AerospaceNU/bms-pcb-design/bms-kicad-project/bms-layout-pdf/bms-board-B_Cu.pdf

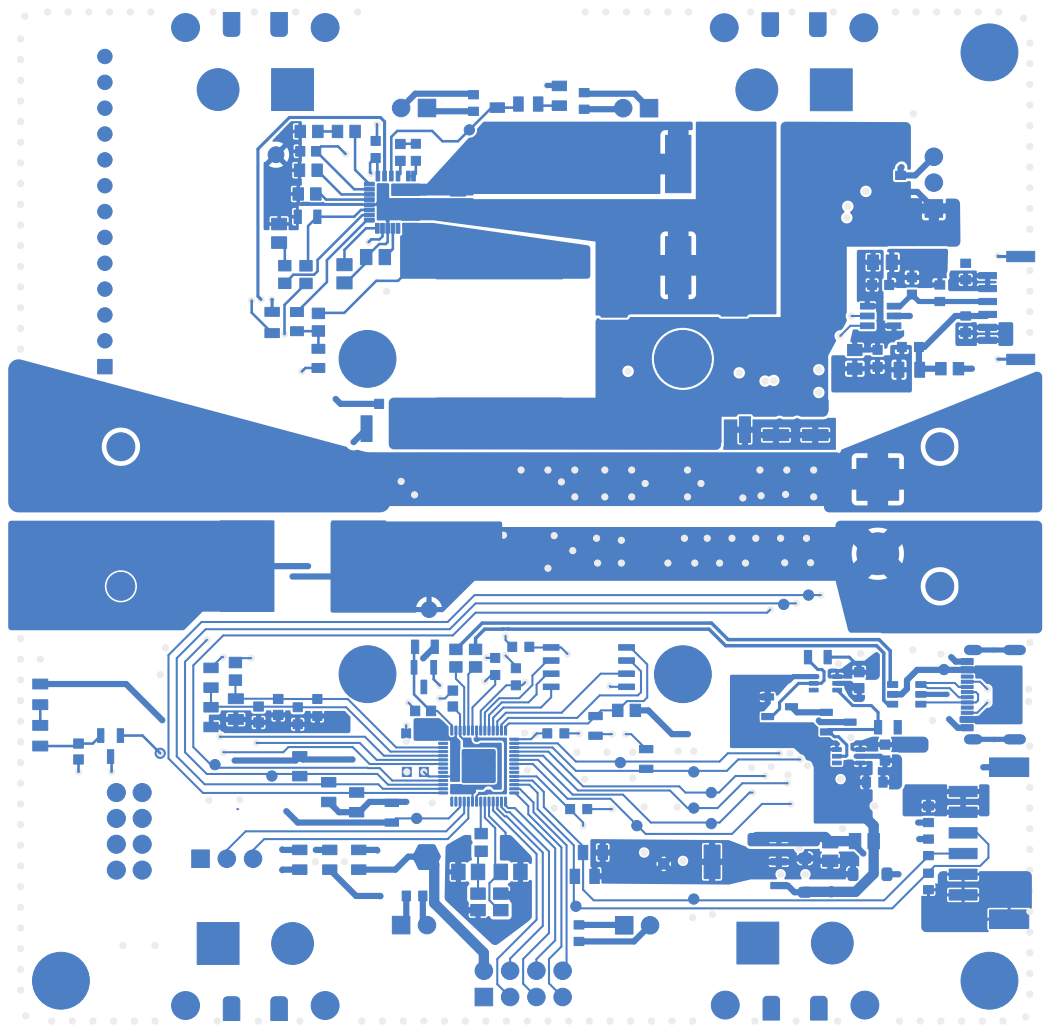
[picture p1: page 1]
