AerospaceNU/bms-pcb-design/bms-kicad-project/bms-layout-pdf/bms-board-B_Mask.pdf

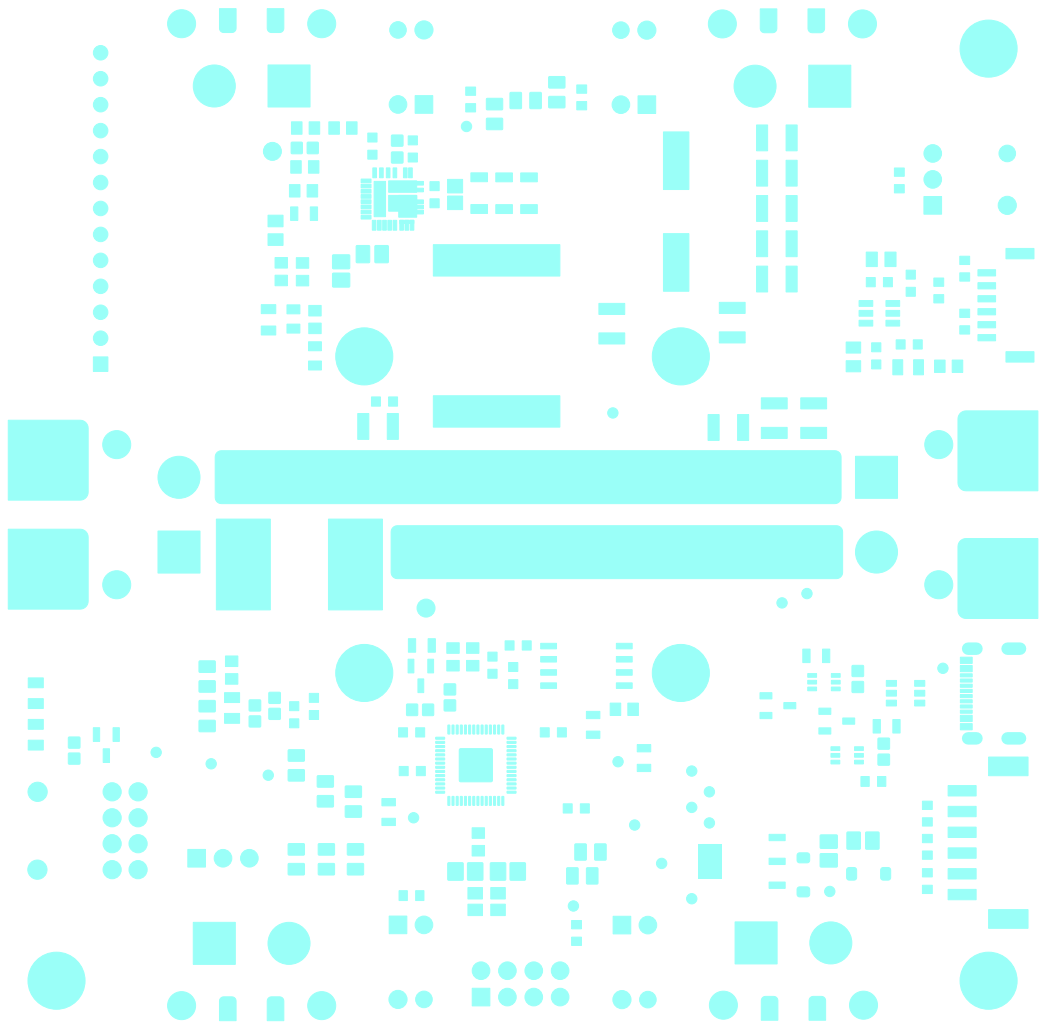
[picture p2: page 1]
