AerospaceNU/bms-pcb-design/bms-kicad-project/bms-layout-pdf/bms-board-B_Paste.pdf

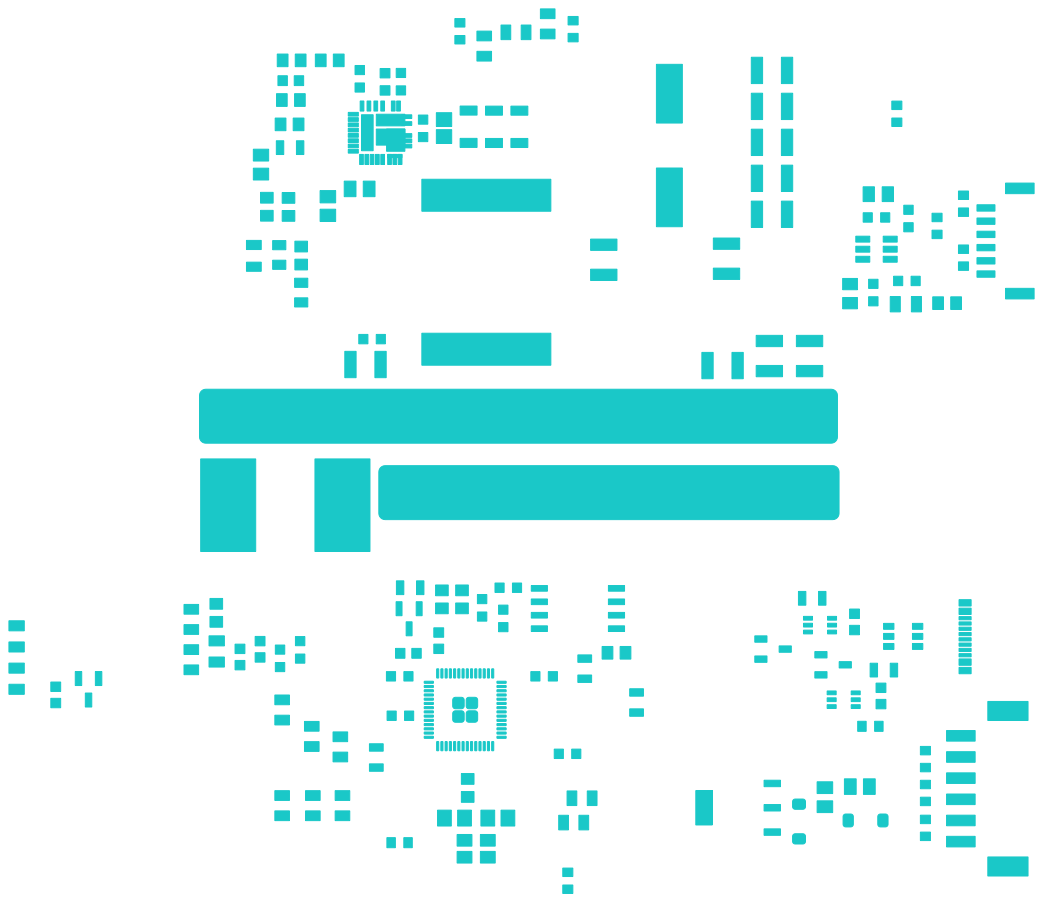
[picture p3: page 1]
