AerospaceNU/bms-pcb-design/bms-kicad-project/bms-layout-pdf/bms-board-B_Silkscreen.pdf

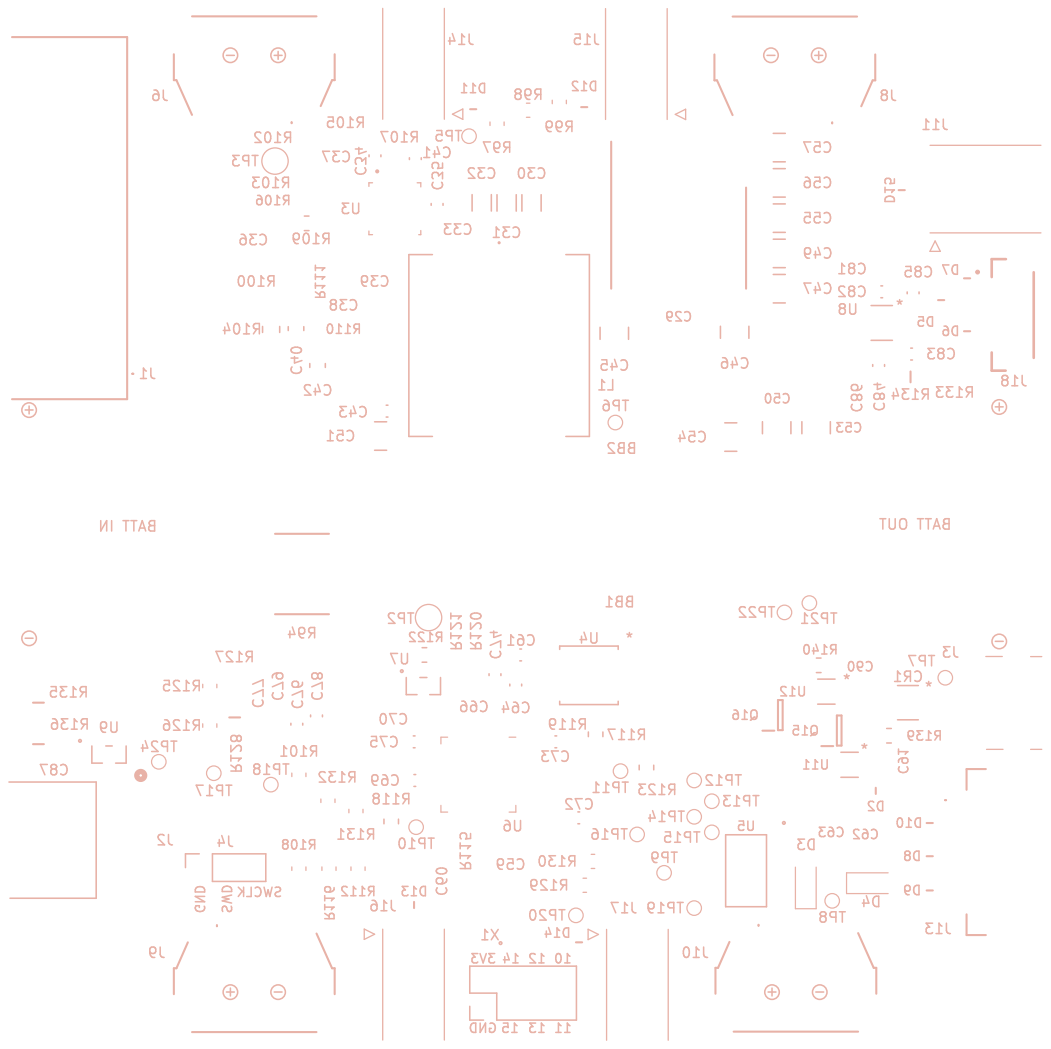
[picture p4: page 1]
