AerospaceNU/bms-pcb-design/bms-kicad-project/bms-layout-pdf/bms-board-Edge_Cuts.pdf

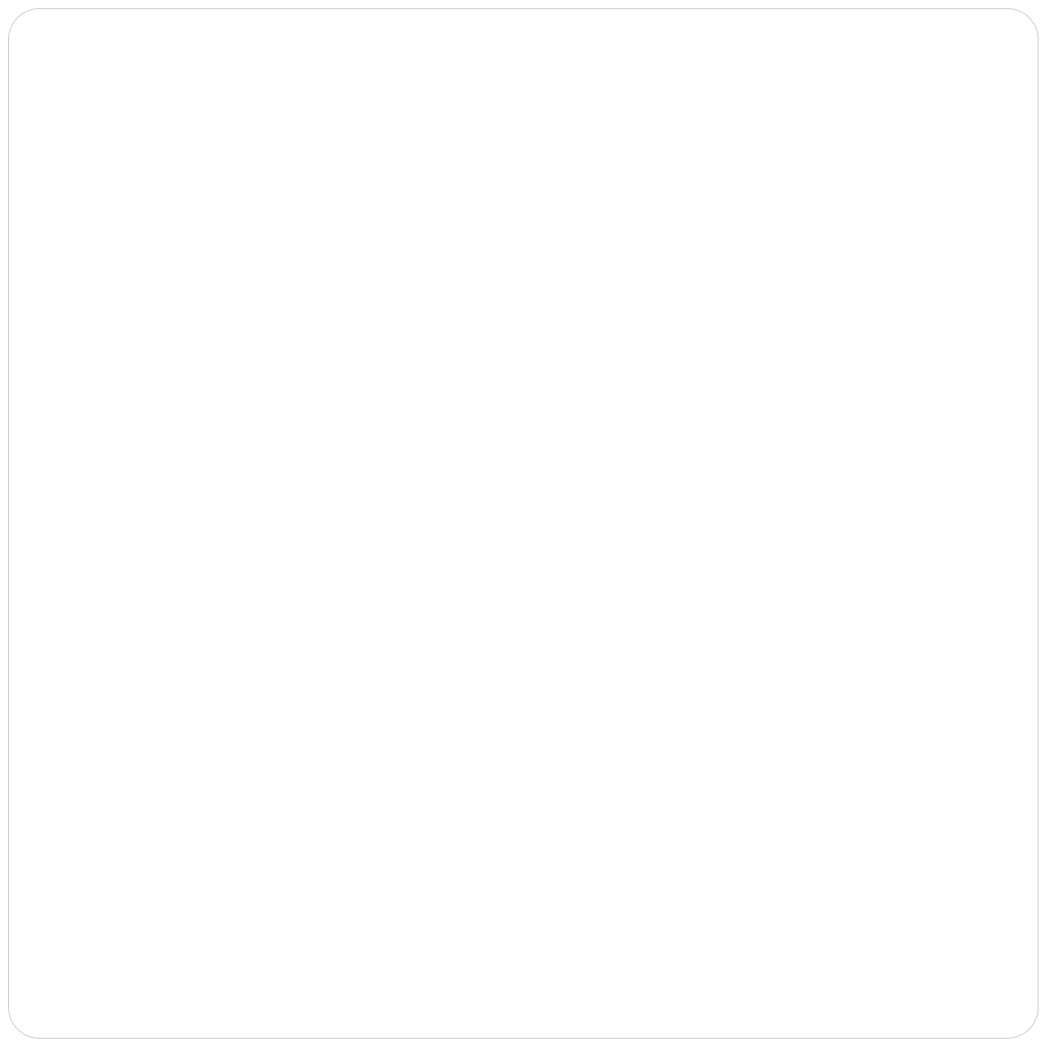
[picture p5: page 1]
