AerospaceNU/bms-pcb-design/bms-kicad-project/bms-layout-pdf/bms-board-F_Cu.pdf

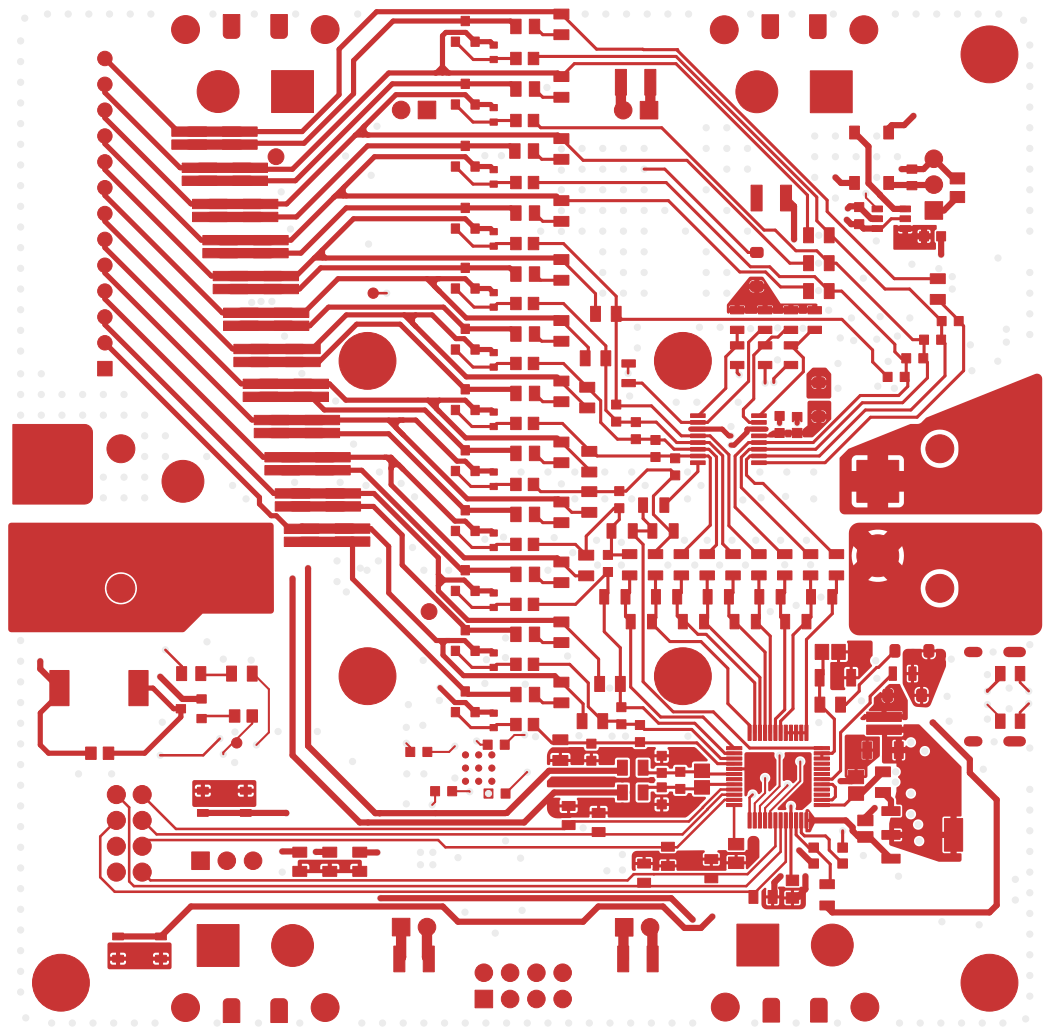
[picture p6: page 1]
