AerospaceNU/bms-pcb-design/bms-kicad-project/bms-layout-pdf/bms-board-F_Mask.pdf

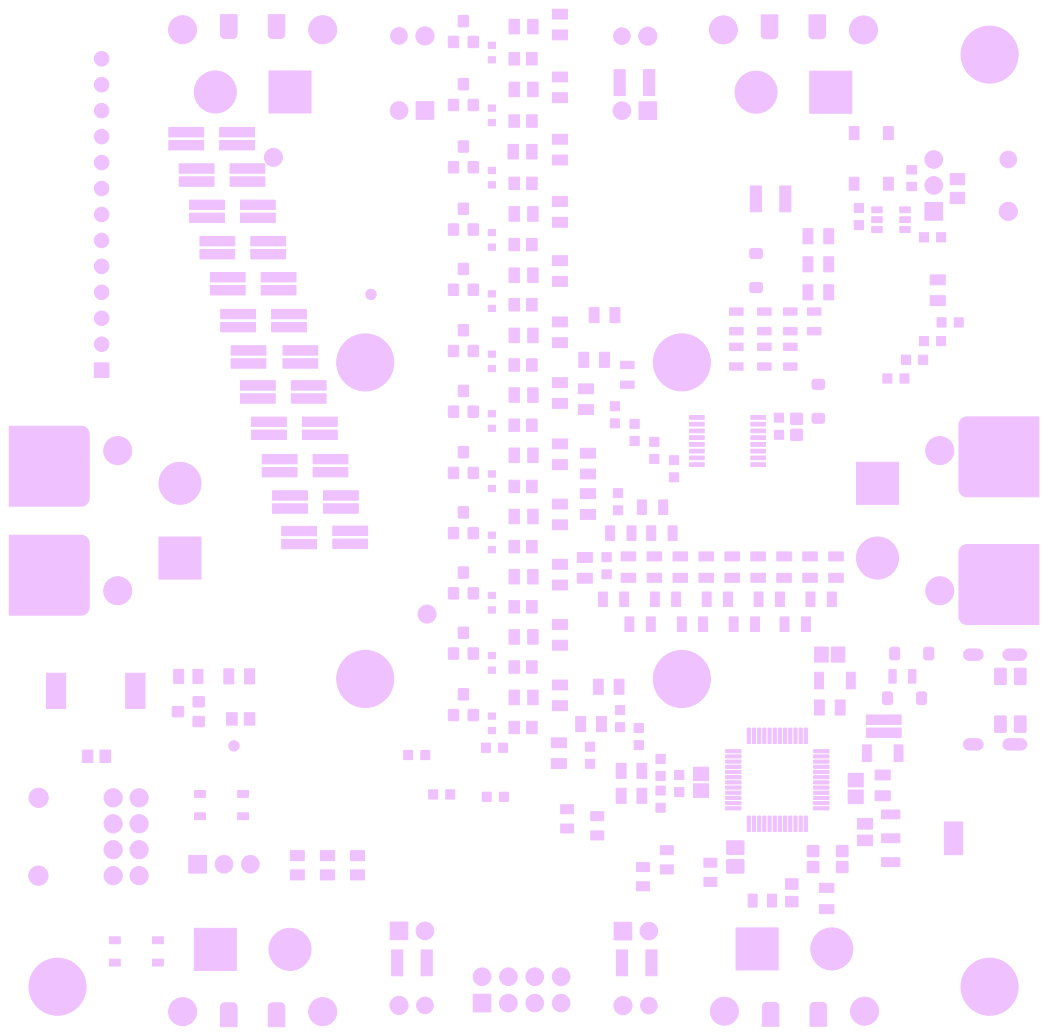
[picture p7: page 1]
