AerospaceNU/bms-pcb-design/bms-kicad-project/bms-layout-pdf/bms-board-F_Paste.pdf

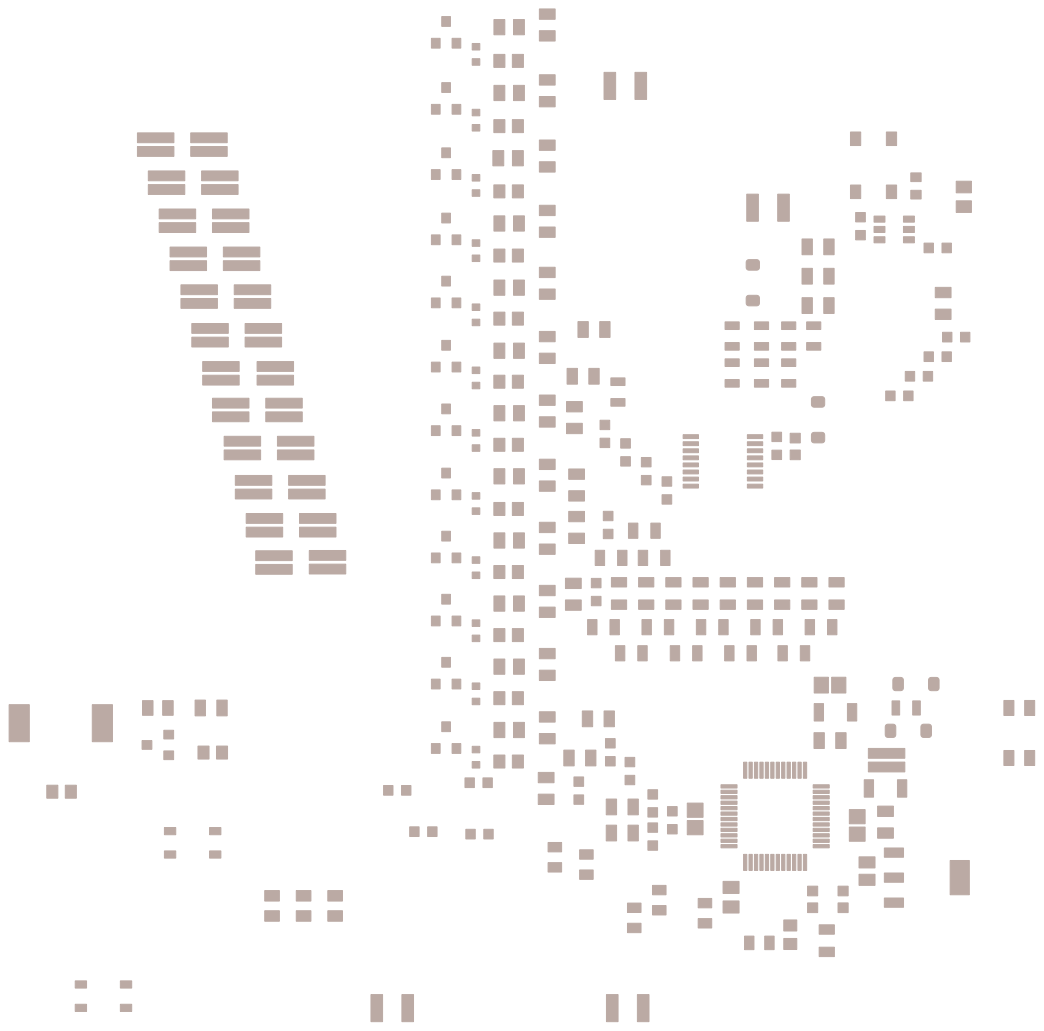
[picture p8: page 1]
