AerospaceNU/bms-pcb-design/bms-kicad-project/bms-layout-pdf/bms-board-F_Silkscreen.pdf

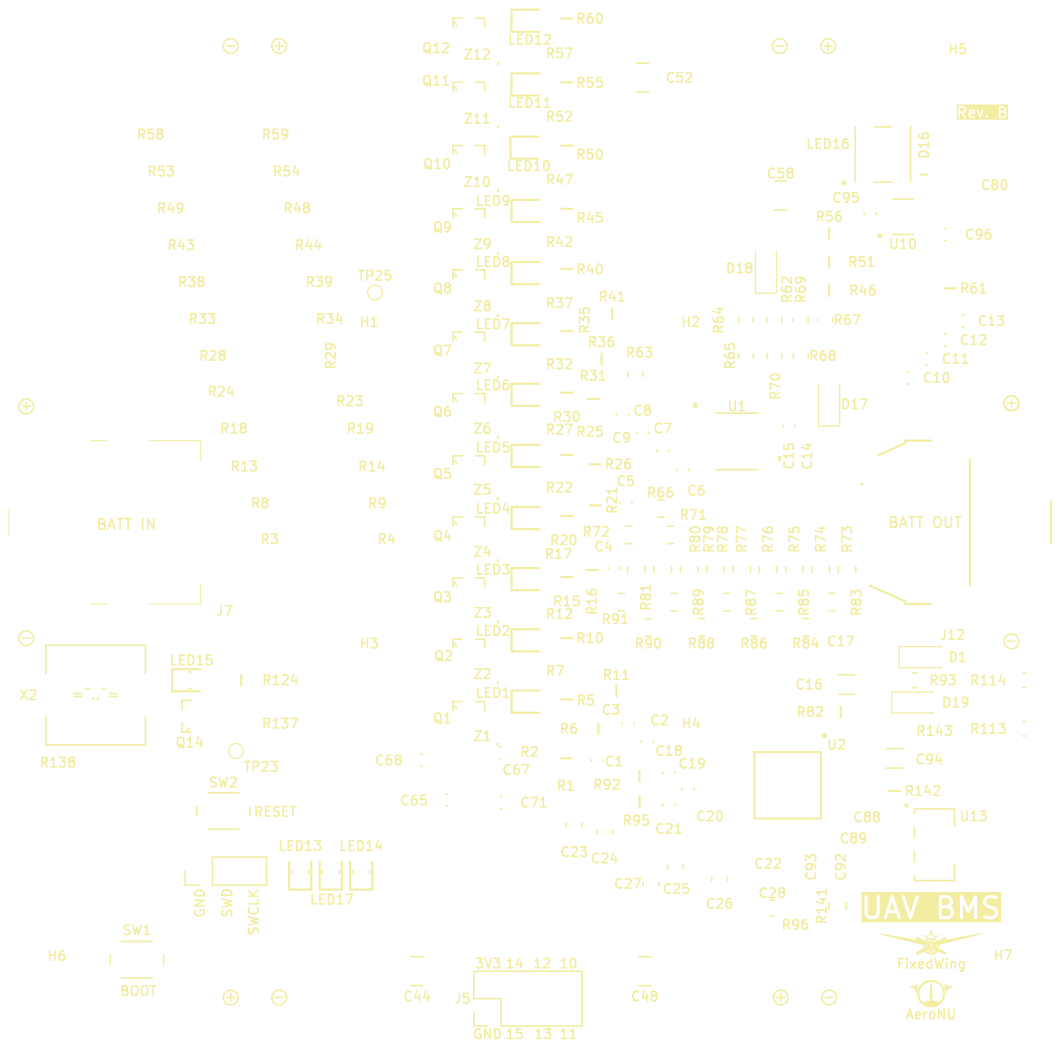
[picture p9: page 1]
