AerospaceNU/bms-pcb-design/bms-kicad-project/bms-layout-pdf/bms-board-In1_Cu.pdf

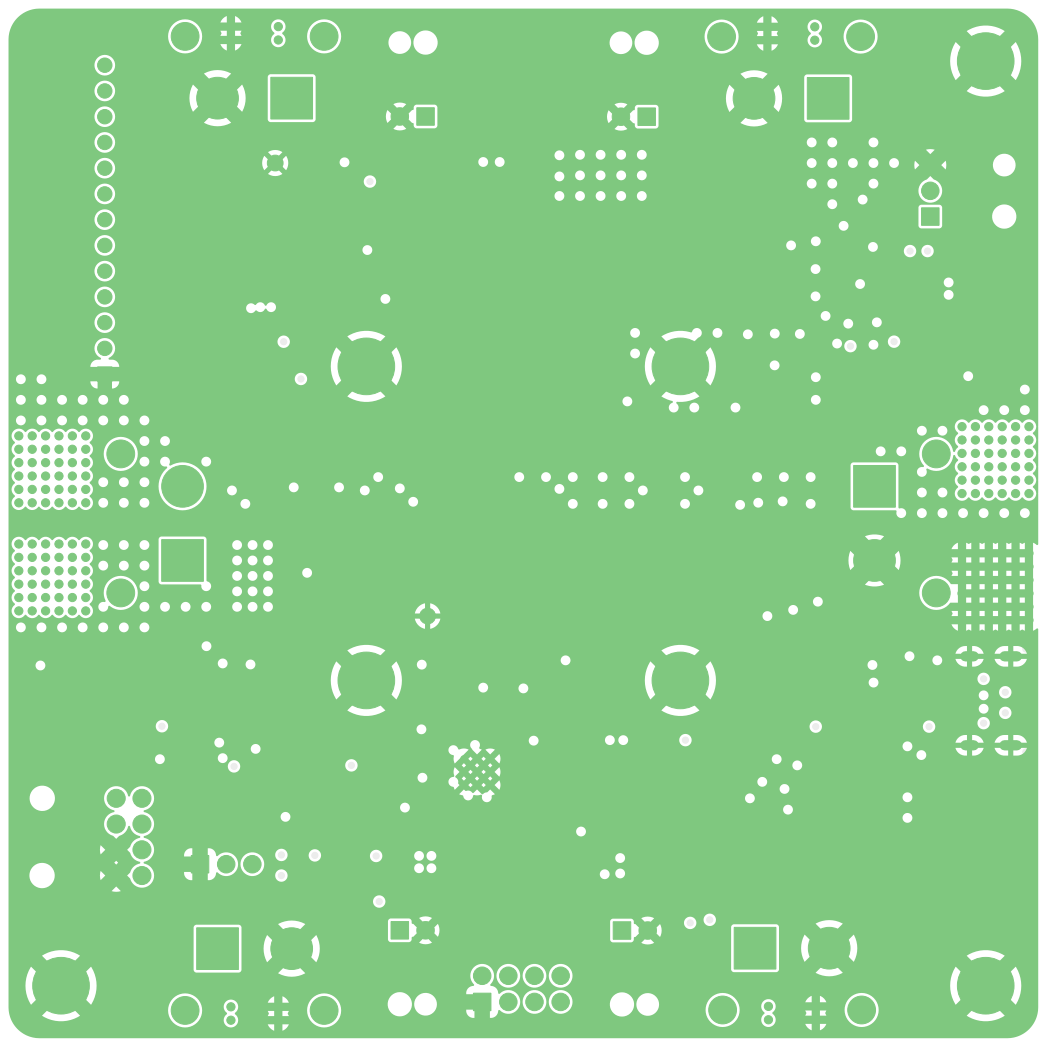
[picture p10: page 1]
