AerospaceNU/bms-pcb-design/bms-kicad-project/bms-layout-pdf/bms-board-In2_Cu.pdf

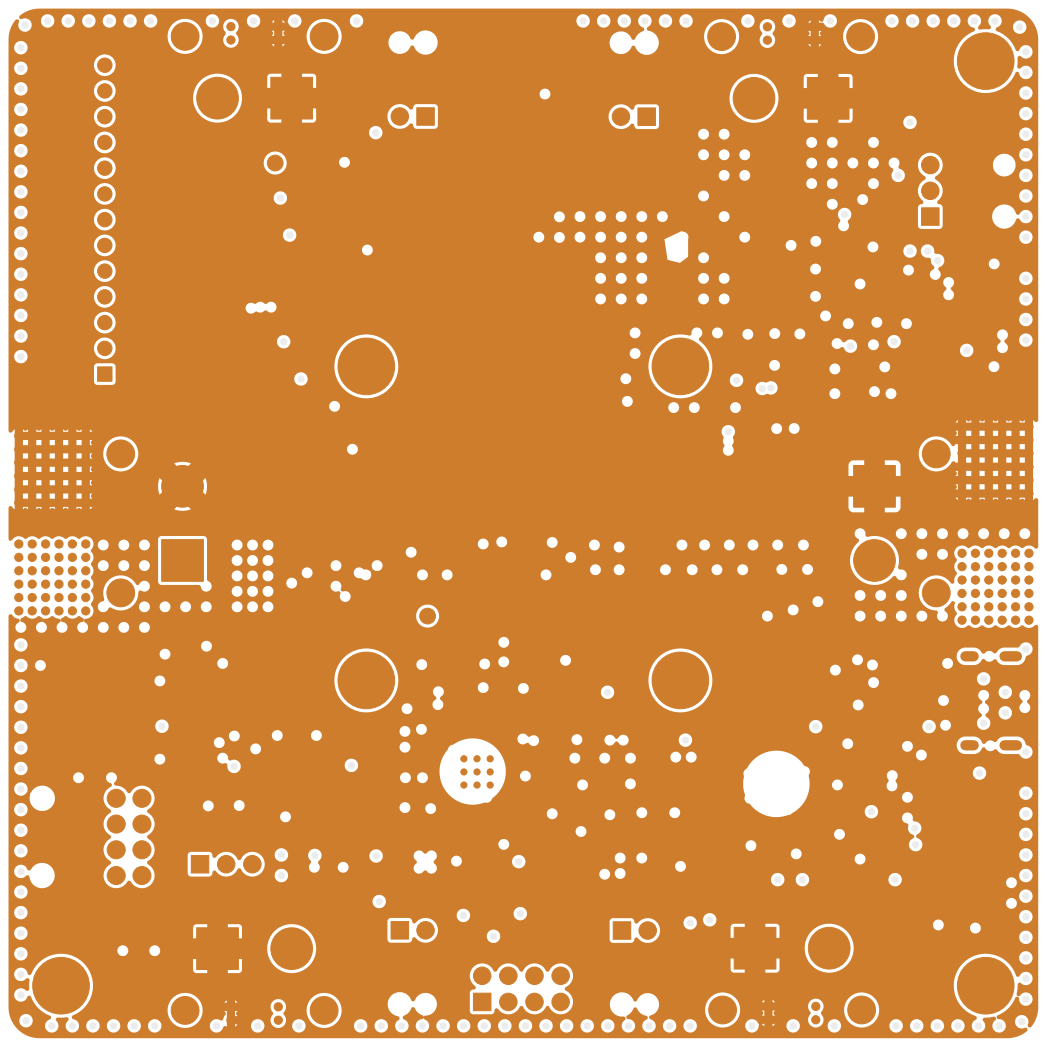
[picture p11: page 1]
