AerospaceNU/bms-pcb-design/bms-kicad-project/bms-layout-pdf/bms-board-In3_Cu.pdf

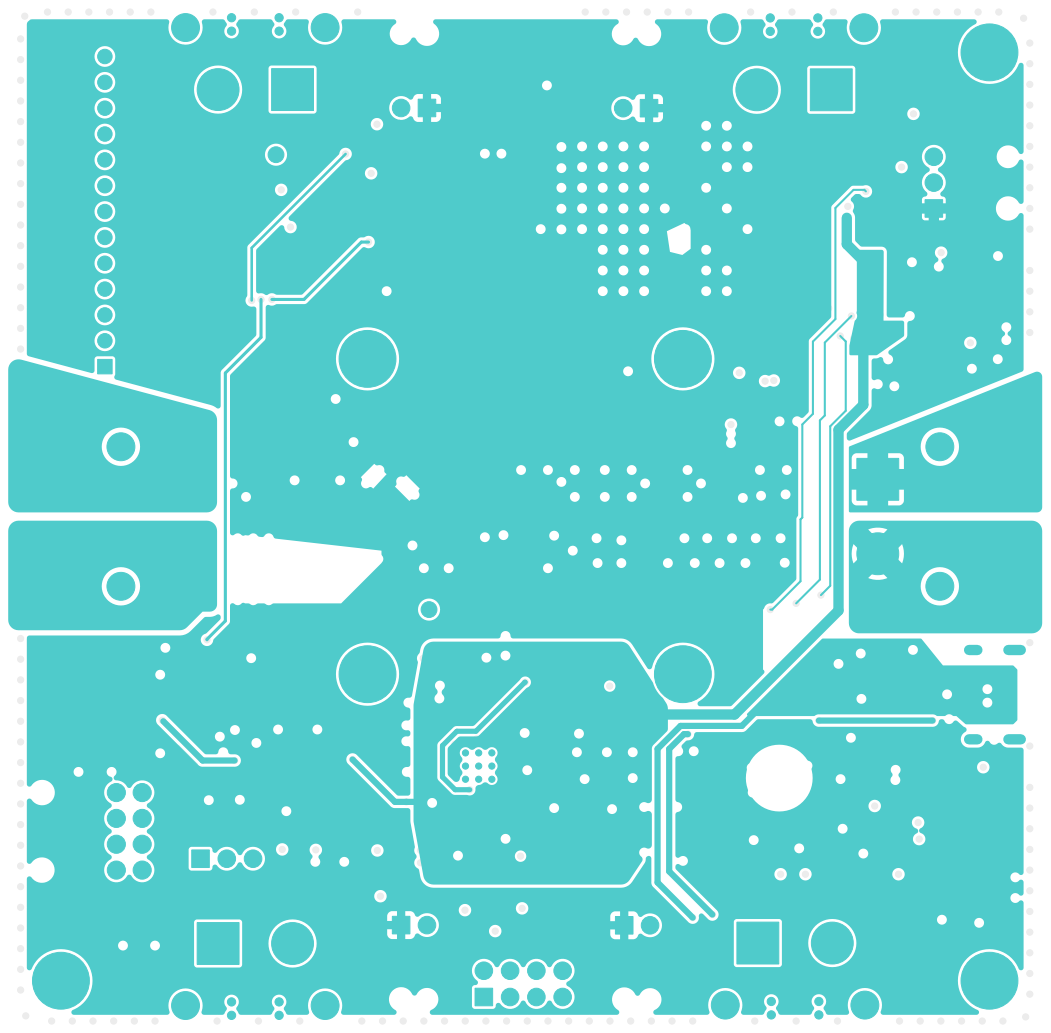
[picture p12: page 1]
