AerospaceNU/bms-pcb-design/bms-kicad-project/bms-layout-pdf/bms-board-In4_Cu.pdf

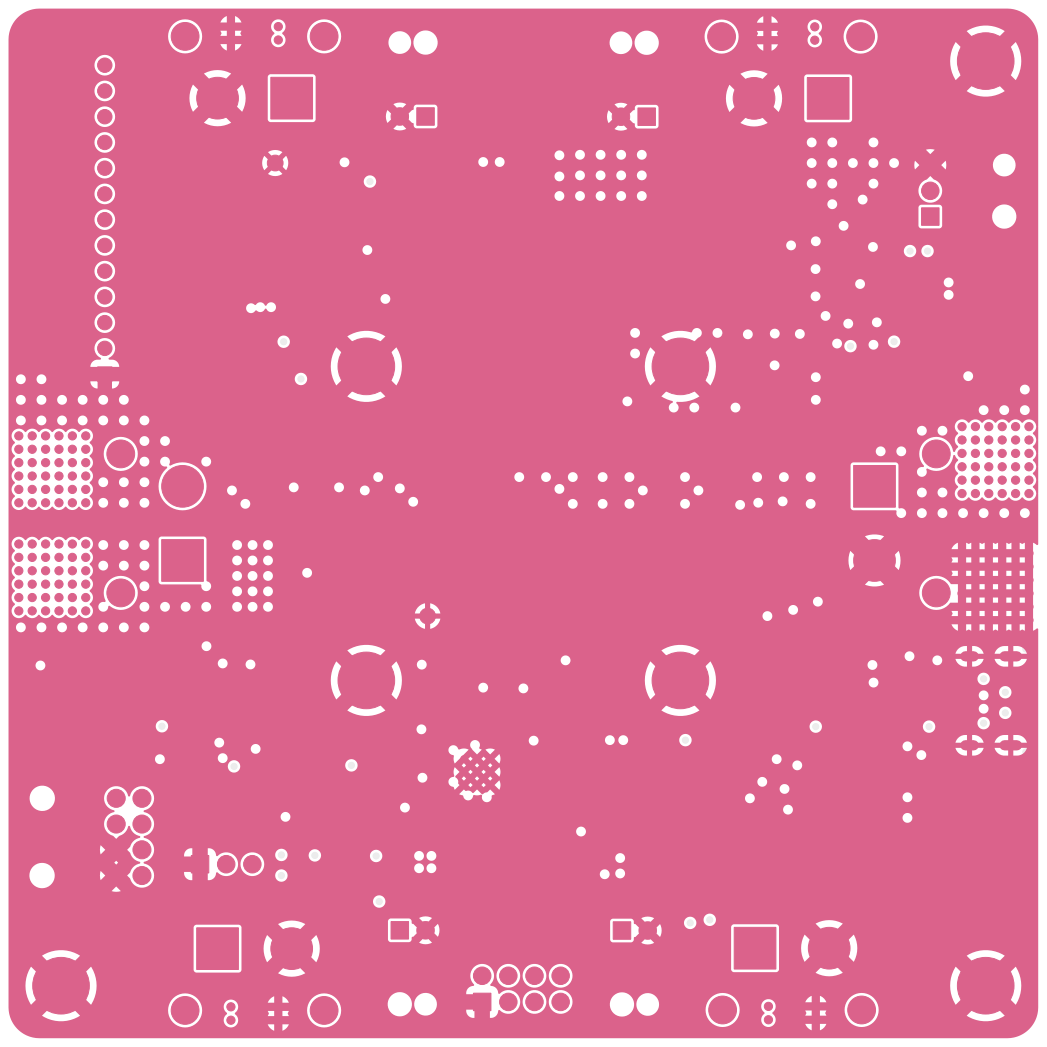
[picture p13: page 1]
