AerospaceNU/bms-pcb-design/sims/5vORing/5vORing.asc

M1: pmos; BSS308PE_L0
M2: pmos; BSS308PE_L0
R1: res; 10k
R2: res; 10k
R3: res; 100
R4: res; 100
R5: res; 100
R_BQ: res; 0.1
R_L: res; 10
R_SIC461: res; 0.1
R_VBUS: res; 0.1
U1: LM66100_TRANS
U2: LM66100_TRANS
V1: voltage; PULSE(0 5.15 0 100m 100m 4 8 1)
V2: voltage; PULSE(0 0 0 100m 100m 2 4 2)
V3: voltage; PULSE(0 5.2 0 100m 100m 1 2 4)
Named nets: 0, OUT, SiC461, VBUS, BQ76972
.include LM66100_TRANS.lib
.tran 0 8s 0 0.1
.include OptiMOS_P3_30V_LTSpice.lib
