AerospaceNU/bms-pcb-design/sims/BalanceLeakage/BalanceLeakage.asc

D1: diode; 1N914
D2: zener; BZX84C6V2L
D3: diode; 1N914
D4: zener; BZX84C6V2L
Q1: npn; DI_DNBT8105
Q2: npn; DI_DNBT8105
R1: res; 7.5
R2: res; 475
R3: res; 100
R4: res; 27
R5: res; 7.5
R6: res; 475
R7: res; 100
R8: res; 27
Rload: res; 5k
V1: voltage; 3.7
V2: voltage; 17
Named nets: 0, +CELL, -CELL, Vc+
.include DNBT8105.txt
.dc V1 17 22 0.1
