AerospaceNU/bms-pcb-design/sims/RailLeakage/PMOSLeakage.asc

D1: schottky
M1: pmos; BSS308PE_L1
R1: res; 10k
R2: res; 100k
VBUS: voltage; 5
Named nets: 0, VBUS, +5V, TP8
.op
.lib OptiMOS_P3_30V_LTSpice.lib
