AerospaceNU/bms-pcb-design/sims/RailLeakage/TVSLeakage.asc

R1: res; 5.1k
R2: res; 5.1k
R3: res; 8.16k
R4: res; 475
U1: USBLC6-2SC6
U2: USBLC6-2SC6
V2: voltage; 3.3
V3: voltage; 3.3
Named nets: 0, +3V3, +5V1, +5V0, +BATT
.op
