AerospaceNU/bms-pcb-design/sims/WS2812Driver/WS2812Driver.asc

M1: nmos; BSS138/ZTX
R1: res; 10k
R2: res; 10k
Rgate: res; 1n
Rsource: res; 1n
V1: voltage; 5.1
V2: voltage; 3.3V
V3: voltage; PULSE(0 3.3 0 5n 5n 5u 10u 10)
Named nets: 0, Vin, Vout
.include DNBT8105.txt
.tran 0 100u 0 50n
.include BSS138.spice.txt
