AerospaceNU/bms-pcb-design/sims/CellBalancingBJT/CellBalancingCircuit.asc

C1: cap; 0.1µ
D1: LED
Q1: npn; DI_DNBT8105
R1: res; 7.5
R2: res; 100
R3: res; 100
R4: res; 25
R5: res; 100
R6: res; 475
V1: voltage; 4
Named nets: 0
.include DNBT8105.txt
.dc V1 3 4.25 0.01
