AerospaceNU/bms-pcb-design/bms-kicad-project/5VPower.kicad_sch

## KiCad design bms-kicad-project/5VPower.kicad_sch (2026-05-07)

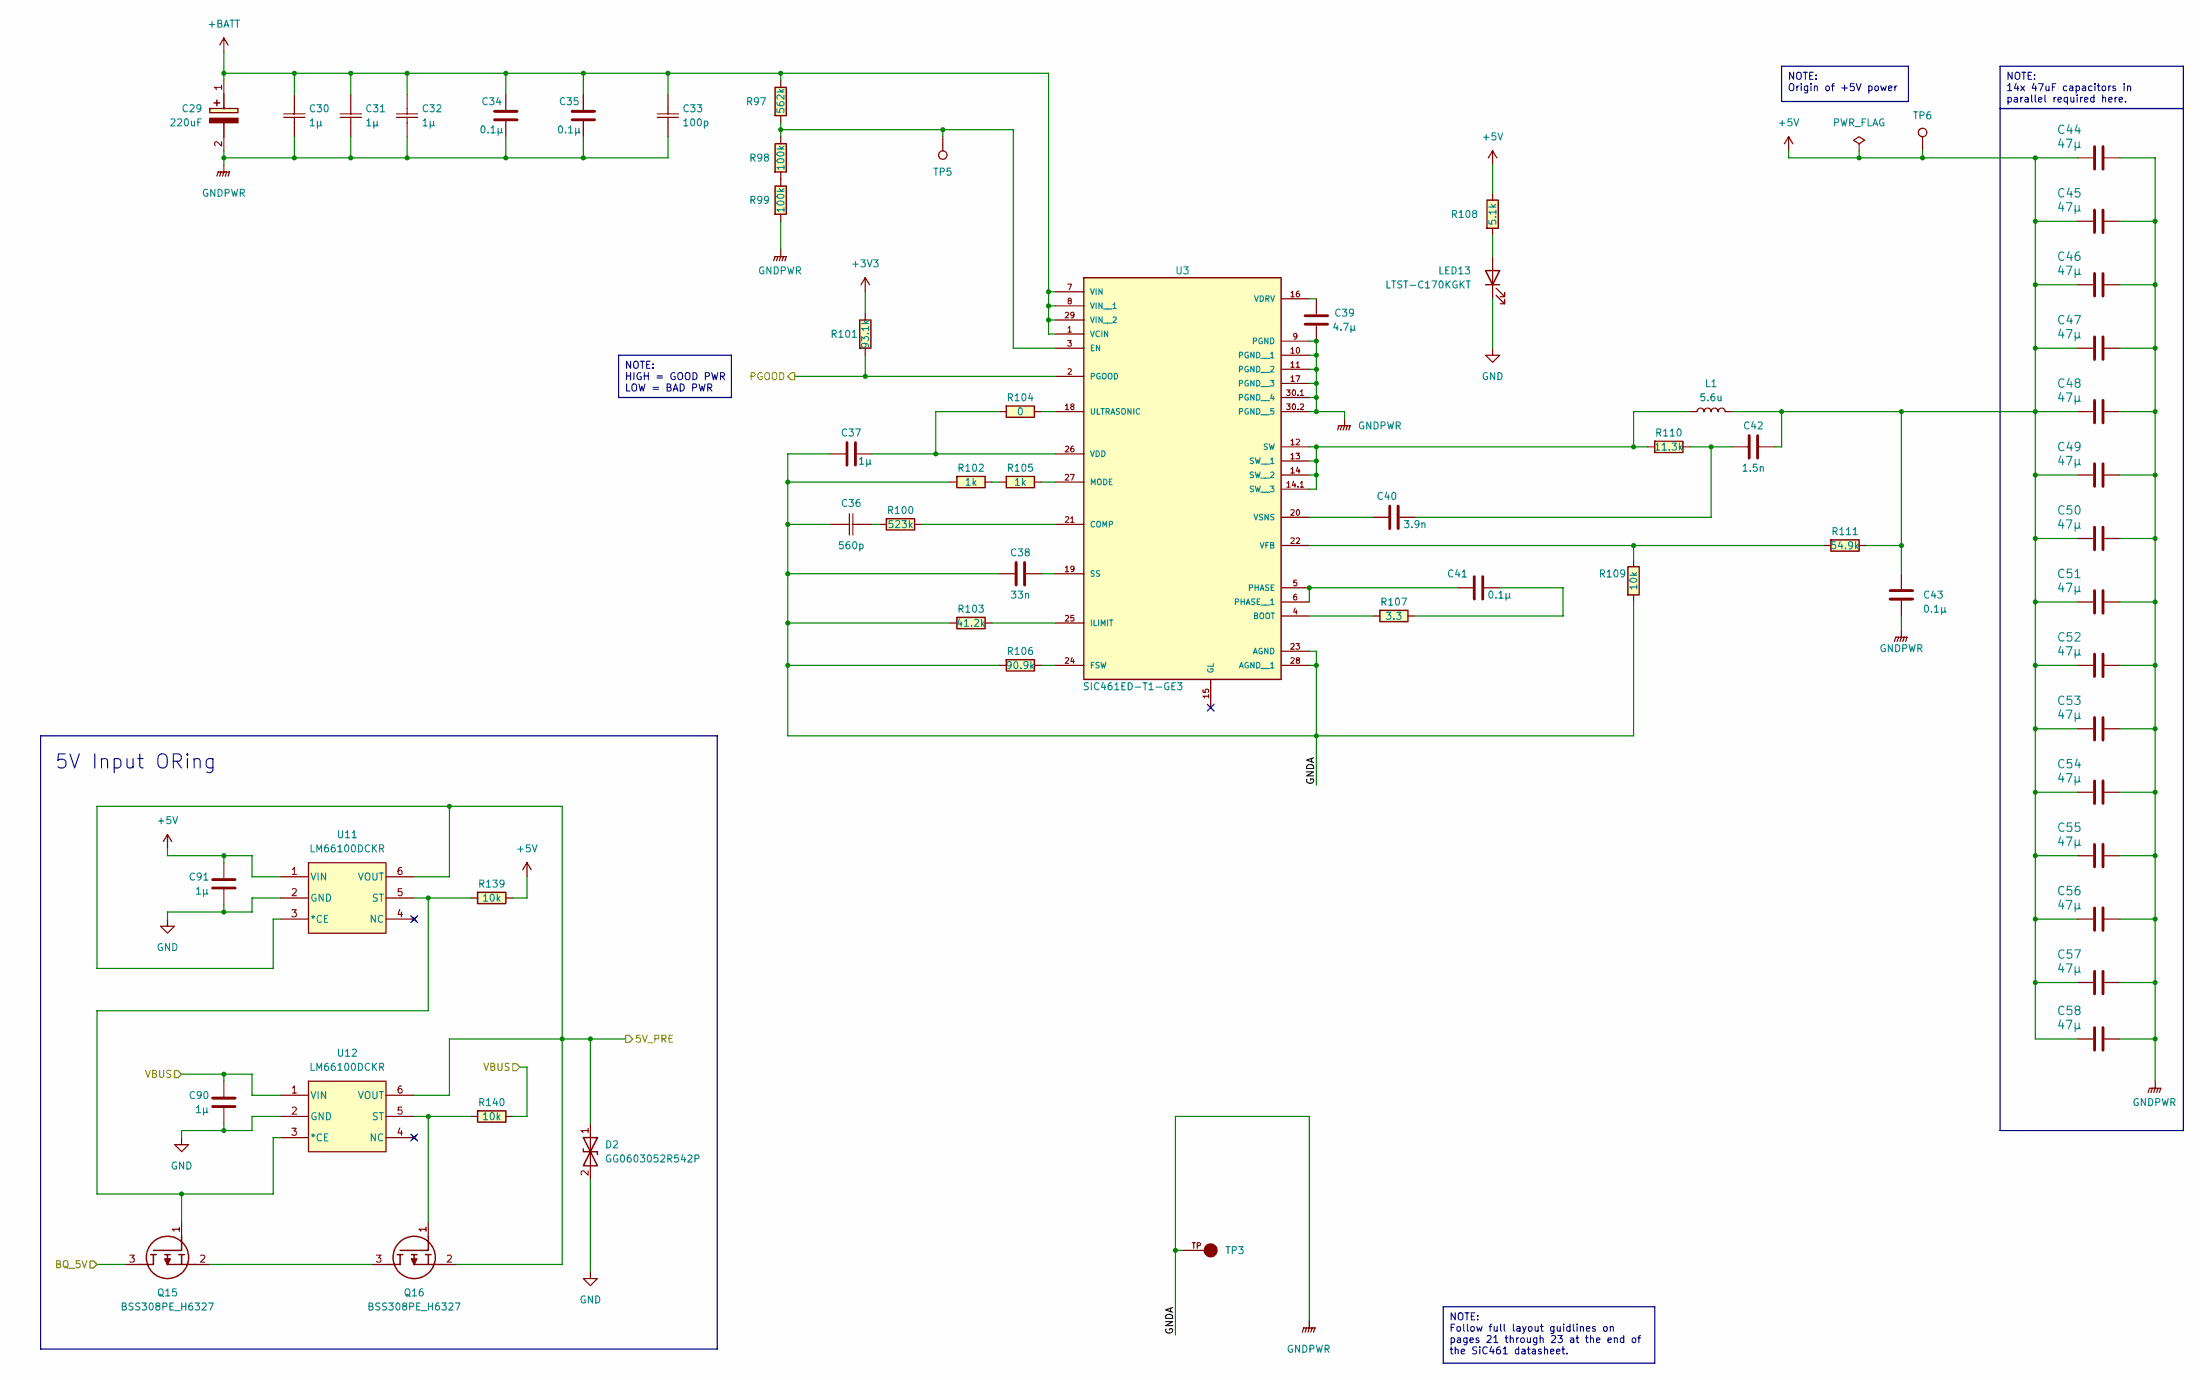
[picture p14: schematic 5VPower.kicad_sch]

Parts:
C29: 220uF; CAPAE1300X1650N; Manufacturer Part Number AEK1216221M080R; Mouser Part Number 581-AEF1216331M050R
C30, C31, C32: 1µ; CAP_CL31_SAM; Manufacturer Part Number CL31B105KCHNNNE
C33: 100p; CAPC220145_88N_KEM; Manufacturer Part Number C0805C101J1GACTU
C34, C35: 0.1µ; CAP_GCJ-18_MUR; Manufacturer Part Number GCJ188R72A104KA01D
C36: 560p; CAP_CC0805_YAG; Manufacturer Part Number CC0805JRNPO9BN561
C37, C90, C91: 1µ; CAPC1608X90N; Manufacturer Part Number GCM188R71C105KA64D
C38: 33n; CAPC2012X94N; Manufacturer Part Number KGM21NR71E333KT
C39: 4.7µ; CAPC2012X145N; Manufacturer Part Number GCM21BC71E475KE36L
C40: 3.9n; G-21_MUR; Manufacturer Part Number GRM2165C1H392JA01D
C41, C43: 0.1µ; CAP_GCJ-18_MUR; Manufacturer_Part_Number GCJ188R72A104KA01D
C42: 1.5n; G-21_MUR; Manufacturer Part Number GRM2165C1H152JA01D
C44, C45, C46, C47, C48, C49, C50, C51, C52, C53, C54, C55, C56, C57, C58: 47µ; G-32_MUR; Manufacturer Part Number GRM32ER71A476KE15L
D2: GG0603052R542P; DIONC1608X70N; Manufacturer Part Number GG0603052R542P
L1: 5.6u; IND_IHLP-6767GZ_VIS; Manufacturer Part Number IHLP6767GZER5R6M01
LED13: LTST-C170KGKT; LED_LTST-C170KGKT_LTO; Manufacturer Part Number LTST-C170KGKT
Q15, Q16: BSS308PE_H6327; SOT95P260X110-3N; Mouser Part Number 726-BSS308PEH6327
R97: 562k; RESC2012X60N; Manufacturer Part Number RC0805FR-07562KL
R98, R99: 100k; RESC2012X60N; Manufacturer Part Number RC0805FR-07100KL
R100: 523k; RC0805N_YAG; Manufacturer Part Number RC0805FR-07523KL
R101: 93.1k; RESC2012X60N; Manufacturer Part Number RC0805FR-0793K1L
R102, R105: 1k; RC0805N_YAG; Manufacturer_Part_Number RC0805FR-071KL
R103: 41.2k; RC0805N_VIS; Manufacturer Part Number CRCW080541K2FKEA
R104: 0; RES_CRCW_0805_VIS; Manufacturer Part Number CRCW08050000Z0EA
R106: 90.9k; RC0805N_YAG; Manufacturer Part Number RC0805FR-0790K9L
R107: 3.3; RESC1608X55N; Manufacturer Part Number RK73H1JTTD3R30F
R108: 5.1k; RESC2012X60N; Manufacturer Part Number RC0805JR-075K1L
R109, R139, R140: 10k; KOA_Speer-RK73H2A-0-0-MFG; power rating 0.125W; tolerance 1%; Manufacturer Part Number RK73H2ATTD1002F; digikey description RES 10K OHM 1% 1/4W 0805
R110: 11.3k; RC0805N_YAG; Manufacturer Part Number RC0805FR-0711K3L
R111: 54.9k; RC0805N_YAG; Manufacturer Part Number RC0805FR-0754K9L
TP3: 5261; KEYSTONE_5261; PARTREV H
TP5, TP6: TestPoint_Pad_D1.0mm
U3: SIC461ED-T1-GE3; CONV_SIC461ED-T1-GE3; PARTREV M
U11, U12: LM66100DCKR; DCK6_TEX; Manufacturer Part Number LM66100DCKR

Connections:
5V_PRE: D2.1 (A1), Q16.2 (S), U11.3 (*CE), U11.6 (VOUT), U12.6 (VOUT)
+3V3: R101.2
+5V: C42.2, C43.2, C44.2, C45.2, C46.2, C47.2, C48.2, C49.2, C50.2, C51.2, C52.2, C53.2, C54.2, C55.2, C56.2, C57.2, C58.2, C91.2, L1.2, R108.2, R111.2, R139.2, TP6.1, U11.1 (VIN)
+BATT: C29.1 (+), C30.2, C31.2, C32.2, C33.2, C34.2, C35.2, R97.2, U3.1 (VCIN), U3.7 (VIN), U3.8 (VIN__1), U3.29 (VIN__2)
BQ_5V: Q15.3 (D)
GND: C90.1, C91.1, D2.2 (A2), LED13.1 (K), U11.2 (GND), U12.2 (GND)
GNDPWR: C29.2 (-), C30.1, C31.1, C32.1, C33.1, C34.1, C35.1, C36.1, C37.2, C38.1, C39.1, C43.1, C44.1, C45.1, C46.1, C47.1, C48.1, C49.1, C50.1, C51.1, C52.1, C53.1, C54.1, C55.1, C56.1, C57.1, C58.1, R99.1, R102.1, R103.1, R106.1, R109.1, TP3.TP, U3.9 (PGND), U3.10 (PGND__1), U3.11 (PGND__2), U3.17 (PGND__3), U3.23 (AGND), U3.28 (AGND__1), U3.30.1 (PGND__4), U3.30.2 (PGND__5)
unnamed: C36.2, R100.1
unnamed: C37.1, R104.1, U3.26 (VDD)
unnamed: C38.2, U3.19 (SS)
unnamed: C39.2, U3.16 (VDRV)
unnamed: C40.1, U3.20 (VSNS)
unnamed: C40.2, C42.1, R110.2
unnamed: C41.1, R107.2
unnamed: C41.2, U3.5 (PHASE), U3.6 (PHASE__1)
unnamed: L1.1, R110.1, U3.12 (SW), U3.13 (SW__1), U3.14 (SW__2), U3.14.1 (SW__3)
unnamed: LED13.2 (A), R108.1
unnamed: Q15.1 (G), R139.1, U11.5 (ST), U12.3 (*CE)
unnamed: Q15.2 (S), Q16.3 (D)
unnamed: Q16.1 (G), R140.1, U12.5 (ST)
unnamed: R97.1, R98.2, TP5.1, U3.3 (EN)
unnamed: R98.1, R99.2
unnamed: R100.2, U3.21 (COMP)
unnamed: R102.2, R105.1
unnamed: R103.2, U3.25 (ILIMIT)
unnamed: R104.2, U3.18 (ULTRASONIC)
unnamed: R105.2, U3.27 (MODE)
unnamed: R106.2, U3.24 (FSW)
unnamed: R107.1, U3.4 (BOOT)
unnamed: R109.2, R111.1, U3.22 (VFB)
PGOOD: R101.1, U3.2 (PGOOD)
VBUS: C90.2, R140.2, U12.1 (VIN)

Notes on the sheet:
NOTE: 14x 47uF capacitors in parallel required here.
NOTE: Origin of +5V power
NOTE: Follow full layout guidlines on pages 21 through 23 at the end of the SiC461 datasheet.
NOTE: HIGH = GOOD PWR LOW = BAD PWR
5V Input ORing
