AerospaceNU/bms-pcb-design/bms-kicad-project/BatteryMonitor.kicad_sch

## KiCad design bms-kicad-project/BatteryMonitor.kicad_sch (2026-05-07)

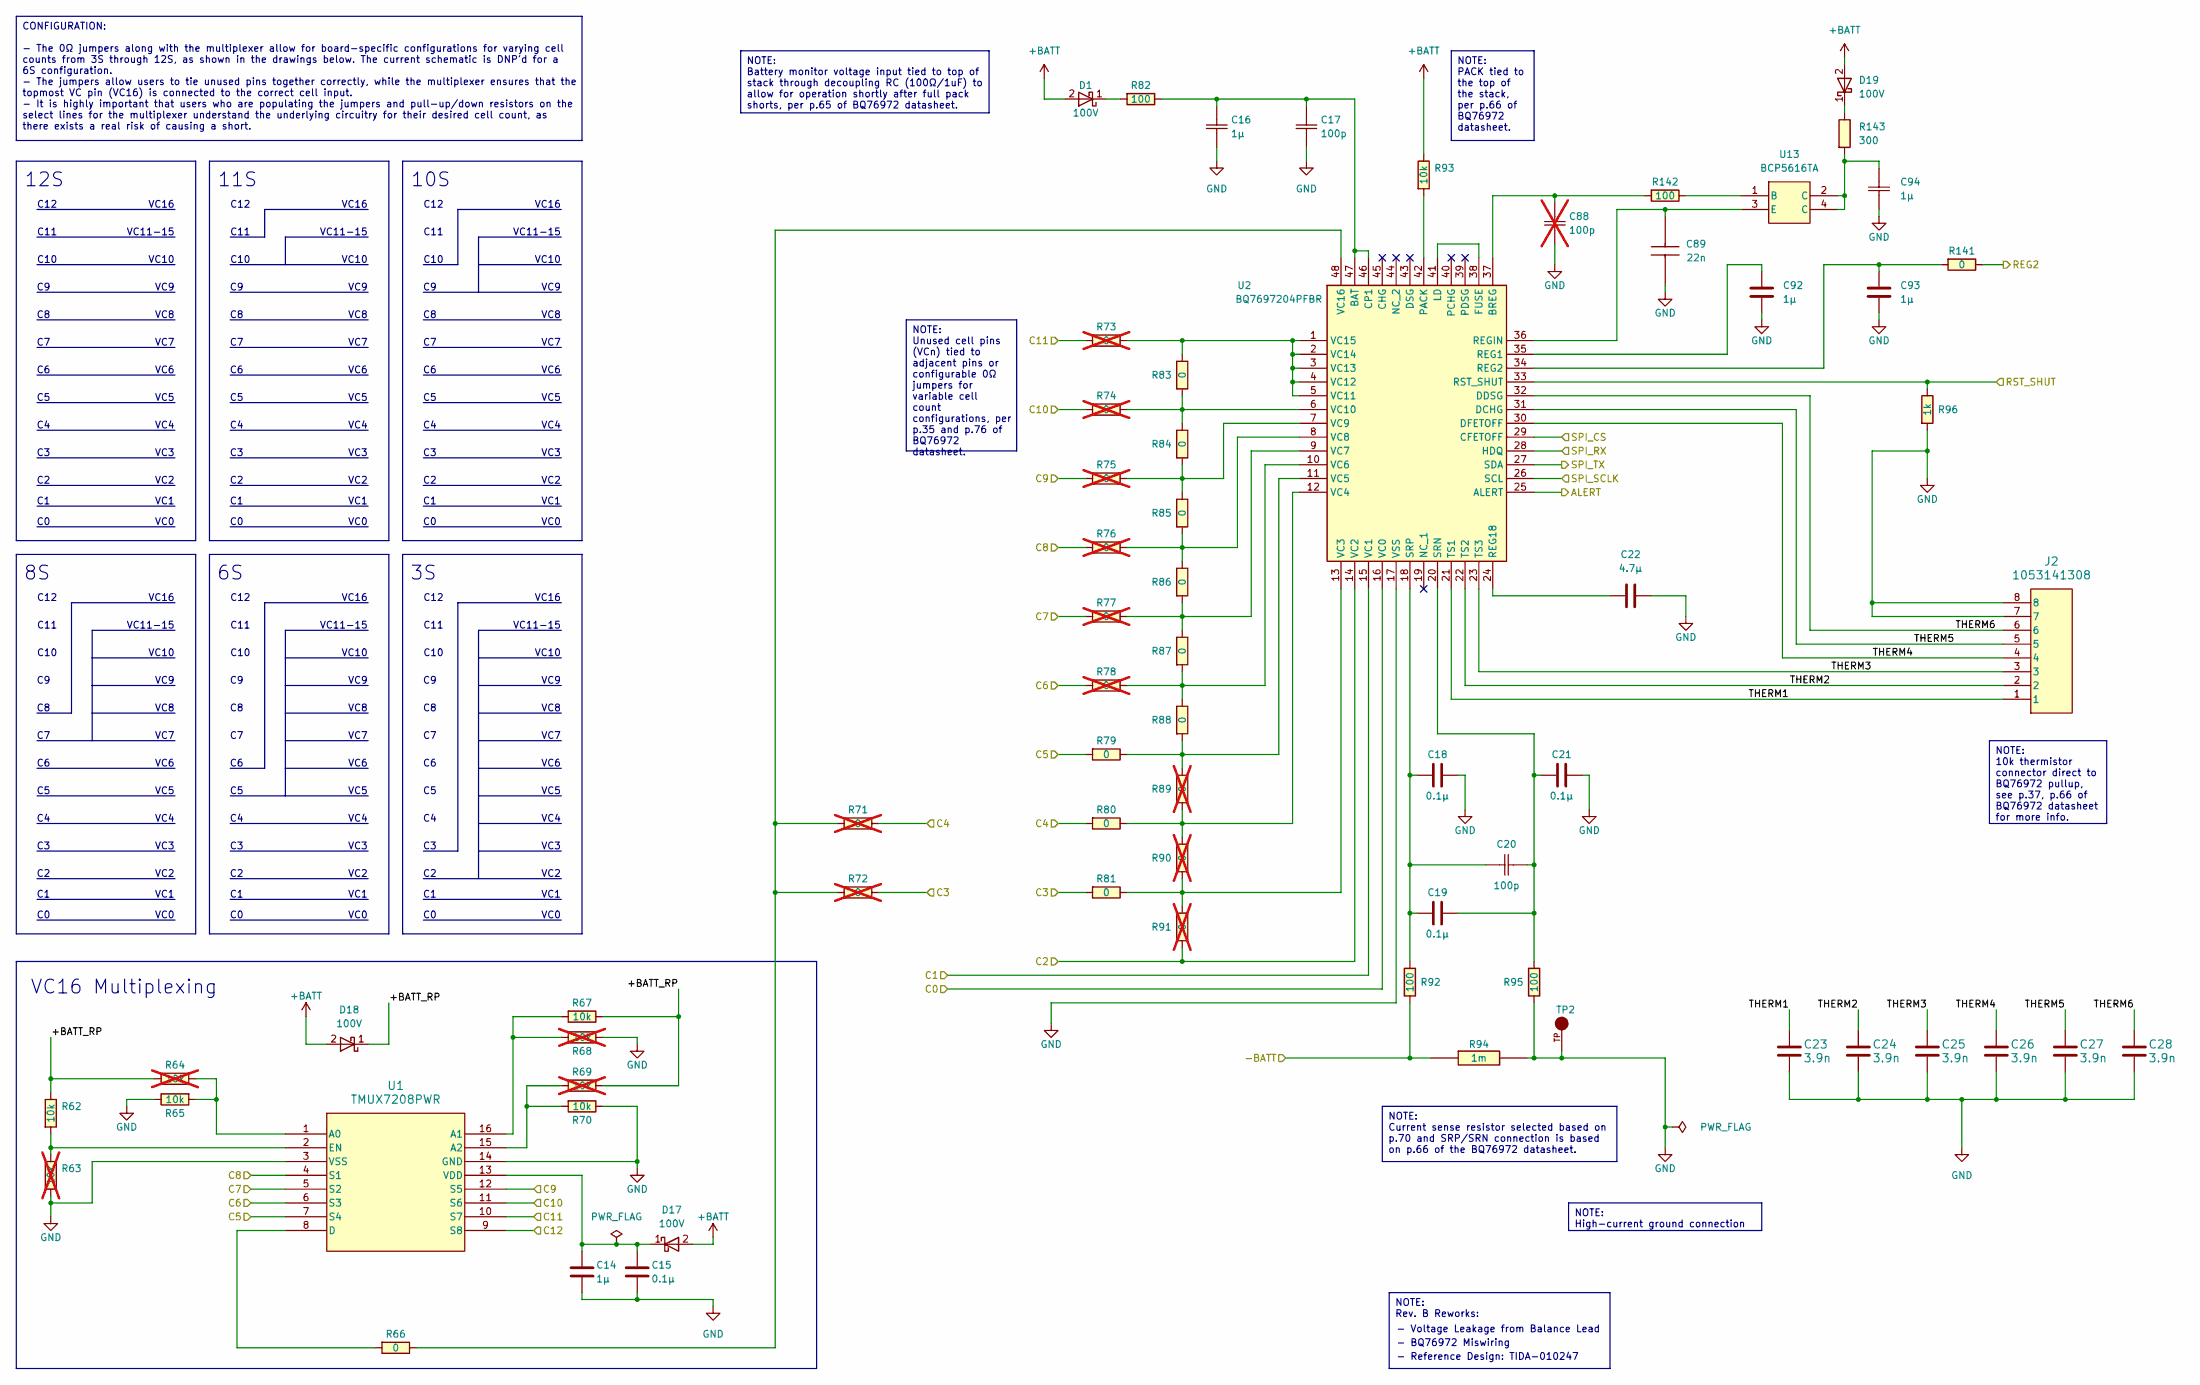
[picture p16: schematic BatteryMonitor.kicad_sch]

Parts:
C14, C92, C93: 1µ; CAPC1608X90N; Manufacturer Part Number GCM188R71C105KA64D
C15, C18, C19, C21: 0.1µ; CAP_GCJ-18_MUR; Manufacturer Part Number GCJ188R72A104KA01D
C16, C94: 1µ; CAP_CL31_SAM; Manufacturer Part Number CL31B105KCHNNNE
C17, C20: 100p; CAPC220145_88N_KEM; Manufacturer Part Number C0805C101J1GACTU
C22: 4.7µ; CAPC2012X145N; Manufacturer Part Number GCM21BC71E475KE36L
C23, C24, C25, C26, C27, C28: 3.9n; G-21_MUR; Manufacturer Part Number GRM2165C1H392JA01D
C88: 100p; CAPC220145_88N_KEM; Manufacturer Part Number C0805C101J1GACTU; not fitted
C89: 22n; CAPC2012X95N; Manufacturer Part Number AC0805JRX7R0BB223
D1, D17, D18, D19: 100V; D_SOD-123; Manufacturer Part Number BAS100AS_R1_00001
J2: 1053141308; CONN_SD-105314-100_08_MOL; Manufacturer Part Number 1053141308
R62, R65, R67, R70, R93: 10k; KOA_Speer-RK73H2A-0-0-MFG; power rating 0.125W; tolerance 1%; Manufacturer Part Number RK73H2ATTD1002F; digikey description RES 10K OHM 1% 1/4W 0805
R63, R64, R68, R69: 10k; KOA_Speer-RK73H2A-0-0-MFG; power rating 0.125W; tolerance 1%; Manufacturer Part Number RK73H2ATTD1002F; digikey description RES 10K OHM 1% 1/4W 0805; not fitted
R66, R79, R80, R81, R83, R84, R85, R86, R87, R88, R141: 0; RES_CRCW_0805_VIS; Manufacturer Part Number CRCW08050000Z0EA
R71, R72, R73, R74, R75, R76, R77, R78, R89, R90, R91: 0; RES_CRCW_0805_VIS; Manufacturer Part Number CRCW08050000Z0EA; not fitted
R82, R92, R95, R142: 100; RESC2012X50N; Mouser Part Number 71-CRCW0805-100-E3
R94: 1m; RES_5930R; Manufacturer Part Number SEWF5930F1L00P9
R96: 1k; RC0805N_YAG; Manufacturer Part Number RC0805FR-071KL
R143: 300; RES_R1632_ROM; Manufacturer Part Number LTR18EZPJ301
TP2: 5261; KEYSTONE_5261; PARTREV H
U1: TMUX7208PWR; TSSOP16-PW_TEX; Manufacturer Part Number TMUX7208PWR
U2: BQ7697204PFBR; QFP50P900X900X120-48N; Manufacturer Part Number BQ7697204PFBR; Mouser Part Number 595-BQ7697202PFBR
U13: BCP5616TA; SOT-223_DIO; Manufacturer Part Number BCP5616TA

Connections:
+BATT: D1.2, D17.2, D18.2, D19.2, R93.2
+BATT_RP: D18.1, R62.2, R64.2, R67.2, R69.2
-BATT: R92.2, R94.1
ALERT: U2.25 (ALERT)
C0: U2.16 (VC0)
C1: U2.15 (VC1)
C2: R91.1, U2.14 (VC2)
C3: R72.2, R81.1
C4: R71.2, R80.1
C5: R79.1, U1.7 (S4)
C6: R78.1, U1.6 (S3)
C7: R77.1, U1.5 (S2)
C8: R76.1, U1.4 (S1)
C9: R75.1, U1.12 (S5)
C10: R74.1, U1.11 (S6)
C11: R73.1, U1.10 (S7)
C12: U1.9 (S8)
GND: C14.1, C15.1, C16.1, C17.1, C18.2, C21.2, C22.2, C23.1, C24.1, C25.1, C26.1, C27.1, C28.1, C88.1, C89.1, C92.1, C93.1, C94.1, J2.7, J2.8, R63.1, R65.2, R68.2, R70.2, R94.2, R95.2, R96.1, TP2.TP, U1.3 (VSS), U1.14 (GND), U2.17 (VSS)
unnamed: C14.2, C15.2, D17.1, U1.13 (VDD)
unnamed: C16.2, C17.2, R82.2, U2.46 (CP1), U2.47 (BAT)
unnamed: C18.1, C19.1, C20.2, R92.1, U2.18 (SRP)
unnamed: C19.2, C20.1, C21.1, R95.1, U2.20 (SRN)
unnamed: C22.1, U2.24 (REG18)
unnamed: C88.2, R142.1, U2.37 (BREG)
unnamed: C89.2, U2.36 (REGIN), U13.3 (E)
unnamed: C92.2, U2.35 (REG1)
unnamed: C93.2, R141.1, U2.34 (REG2)
unnamed: C94.2, R143.1, U13.2 (C), U13.4 (C)
unnamed: D1.1, R82.1
unnamed: D19.1, R143.2
unnamed: R62.1, R63.2, U1.2 (EN)
unnamed: R64.1, R65.1, U1.1 (A0)
unnamed: R66.1, U1.8 (D)
unnamed: R66.2, R71.1, R72.1, U2.48 (VC16)
unnamed: R67.1, R68.1, U1.16 (A1)
unnamed: R69.1, R70.1, U1.15 (A2)
unnamed: R73.2, R83.2, U2.1 (VC15), U2.2 (VC14), U2.3 (VC13), U2.4 (VC12), U2.5 (VC11)
unnamed: R74.2, R83.1, R84.2, U2.6 (VC10)
unnamed: R75.2, R84.1, R85.2, U2.7 (VC9)
unnamed: R76.2, R85.1, R86.2, U2.8 (VC8)
unnamed: R77.2, R86.1, R87.2, U2.9 (VC7)
unnamed: R78.2, R87.1, R88.2, U2.10 (VC6)
unnamed: R79.2, R88.1, R89.2, U2.11 (VC5)
unnamed: R80.2, R89.1, R90.2, U2.12 (VC4)
unnamed: R81.2, R90.1, R91.2, U2.13 (VC3)
unnamed: R93.1, U2.42 (PACK)
unnamed: R142.2, U13.1 (B)
unnamed: U2.38 (FUSE), U2.41 (LD)
REG2: R141.2
RST_SHUT: R96.2, U2.33 (RST_SHUT)
SPI_CS: U2.29 (CFETOFF)
SPI_RX: U2.28 (HDQ)
SPI_SCLK: U2.26 (SCL)
SPI_TX: U2.27 (SDA)
THERM1: C23.2, J2.1, U2.21 (TS1)
THERM2: C24.2, J2.2, U2.22 (TS2)
THERM3: C25.2, J2.3, U2.23 (TS3)
THERM4: C26.2, J2.4, U2.30 (DFETOFF)
THERM5: C27.2, J2.5, U2.31 (DCHG)
THERM6: C28.2, J2.6, U2.32 (DDSG)

Notes on the sheet:
NOTE: Unused cell pins (VCn) tied to adjacent pins or configurable 0Ω jumpers for variable cell count configurations, per p.35 and p.76 of BQ76972 datasheet.
NOTE: PACK tied to the top of the stack, per p.66 of BQ76972 datasheet.
NOTE: Battery monitor voltage input tied to top of stack through decoupling RC (100Ω/1uF) to allow for operation shortly after full pack shorts, per p.65 of BQ76972 datasheet.
NOTE: Current sense resistor selected based on p.70 and SRP/SRN connection is based on p.66 of the BQ76972 datasheet.
NOTE: High-current ground connection
CONFIGURATION: - The 0Ω jumpers along with the multiplexer allow for board-specific configurations for varying cell counts from 3S through 12S, as shown in the drawings below. The current schematic is DNP'd for a 6S configuration. - The jumpers allow users to tie unused pins together correctly, whi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
NOTE: Rev. B Reworks:
NOTE: 10k thermistor connector direct to BQ76972 pullup, see p.37, p.66 of BQ76972 datasheet for more info.
VC2
VC9
VC1
C10
12S
C12
VC10
VC3
VC16
C11
VC5
VC6
VC7
VC4
VC0
VC8
VC11-15
10S
- BQ76972 Miswiring
- Voltage Leakage from Balance Lead
VC16 Multiplexing
11S
- Reference Design: TIDA-010247
