AerospaceNU/bms-pcb-design/bms-kicad-project/CellFilteringAndBalancing.kicad_sch

## KiCad design bms-kicad-project/CellFilteringAndBalancing.kicad_sch (2026-05-07)

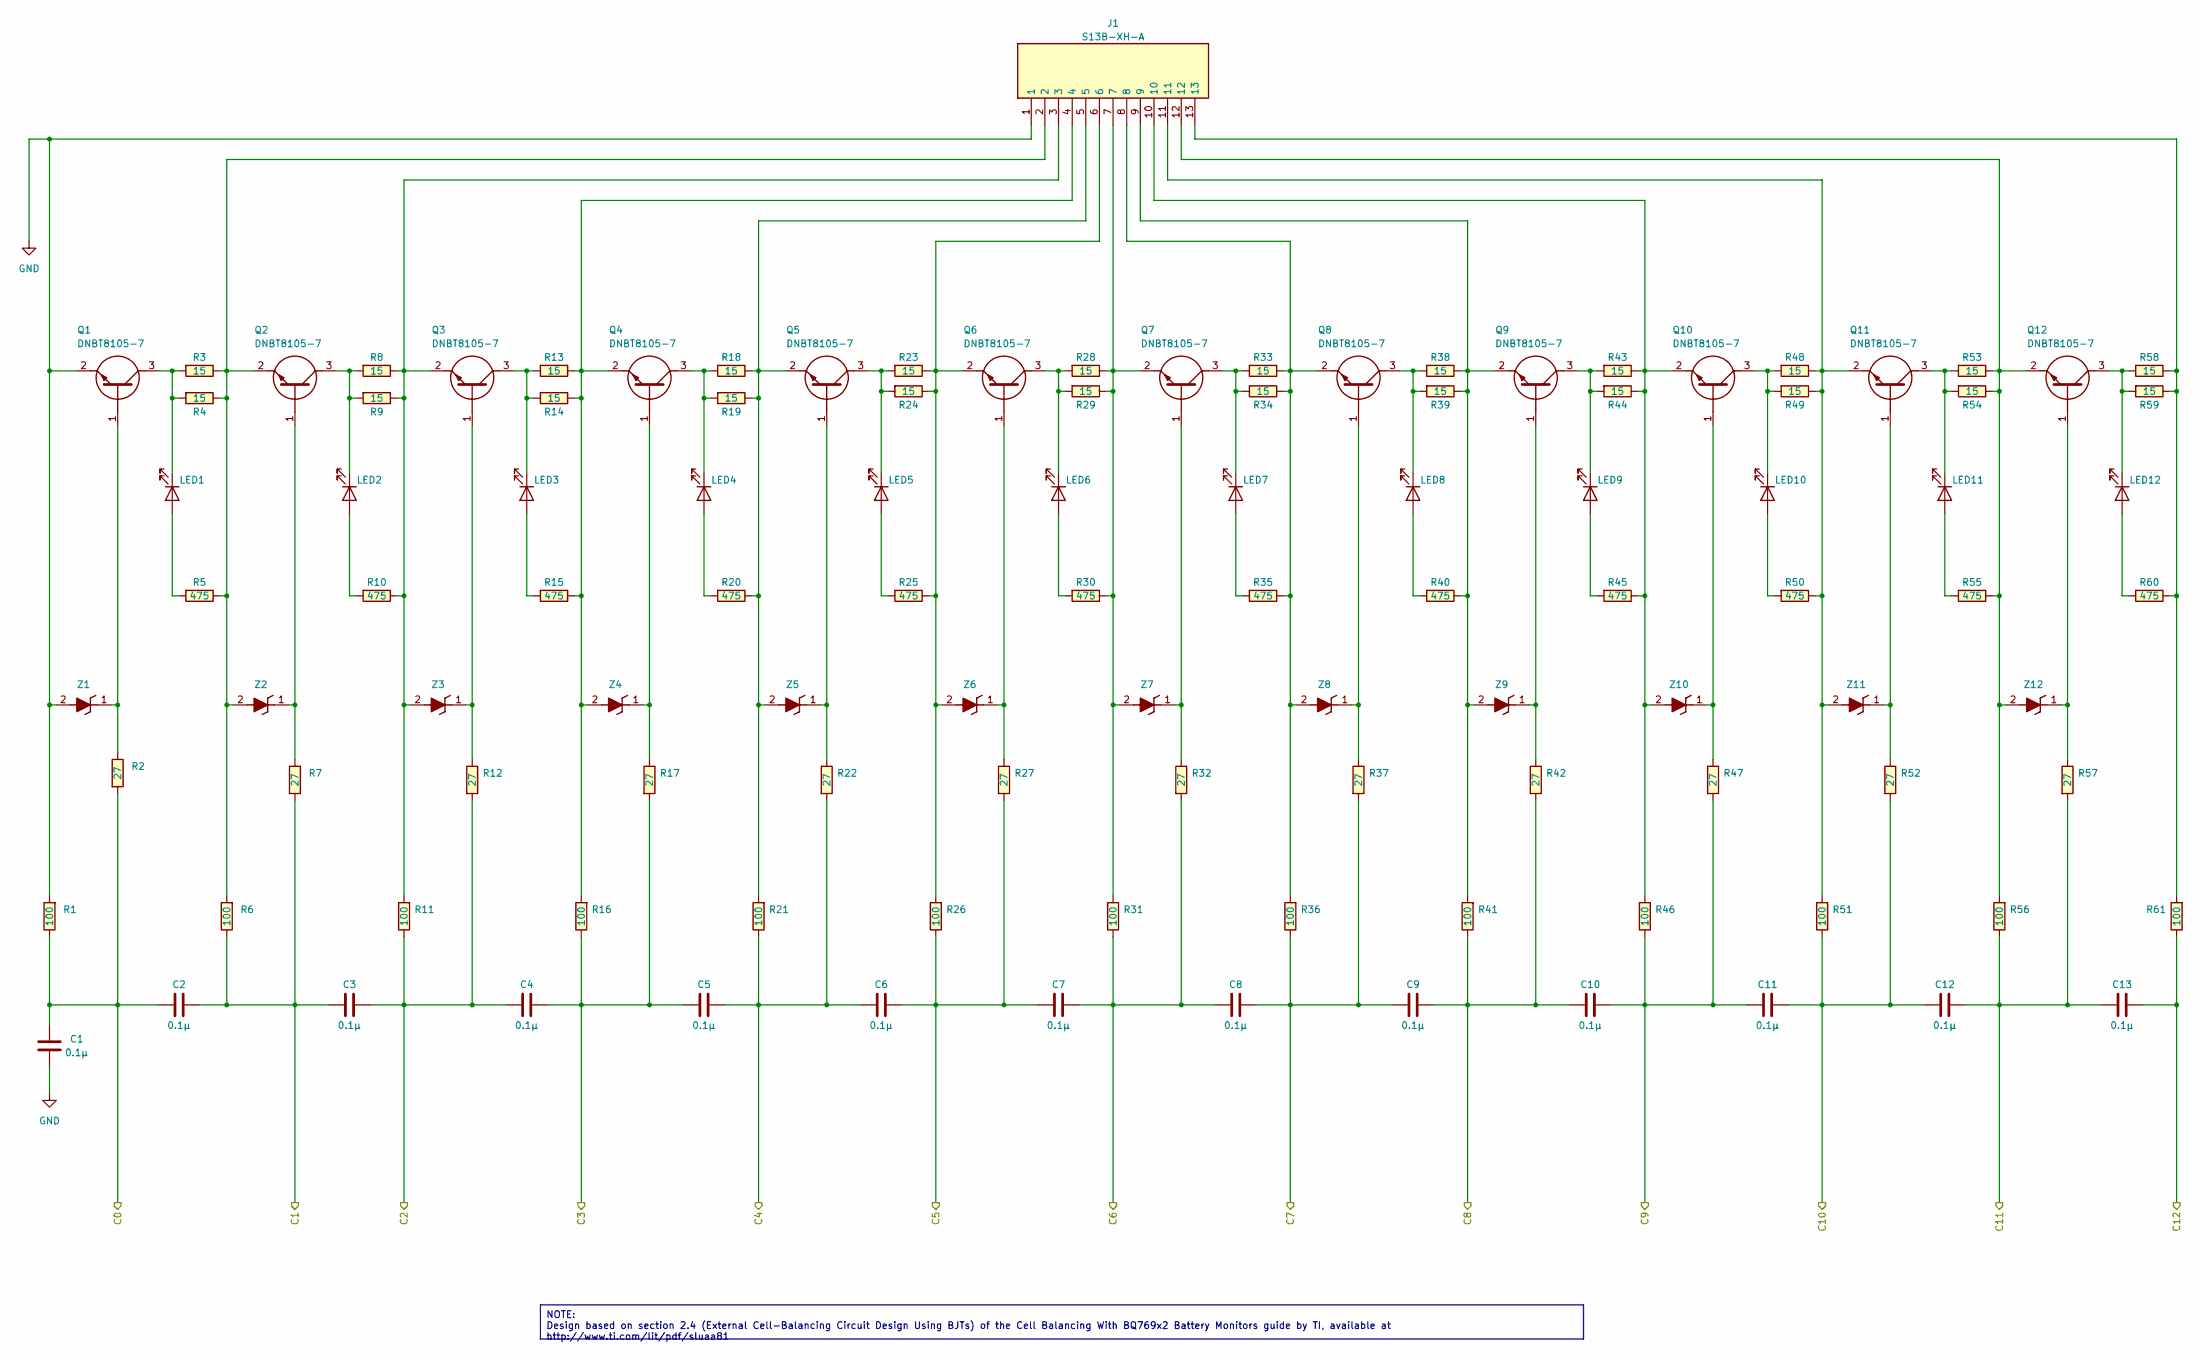
[picture p17: schematic CellFilteringAndBalancing.kicad_sch]

Parts:
C1, C2, C3, C4, C5, C6, C7, C8, C9, C10, C11, C12, C13: 0.1µ; CAP_GCJ-18_MUR; Manufacturer Part Number GCJ188R72A104KA01D
J1: S13B-XH-A; S13BXHALFSN; Manufacturer Part Number S13B-XH-A
LED1, LED2, LED3, LED4, LED5, LED6, LED7, LED8, LED9, LED10, LED11, LED12: LTST-C170KRKT; LEDC2012X120N; Mouser Part Number 859-LTST-C170KRKT
Q1, Q2, Q3, Q4, Q5, Q6, Q7, Q8, Q9, Q10, Q11, Q12: DNBT8105-7; SOT95P240X105-3N; Manufacturer Part Number DNBT8105-7; Mouser Part Number 621-DNBT8105-7
R1, R6, R11, R16, R21, R26, R31, R36, R41, R46, R51, R56, R61: 100; RESC2012X50N; Mouser Part Number 71-CRCW0805-100-E3
R2, R7, R12, R17, R22, R27, R32, R37, R42, R47, R52, R57: 27; RC0805N_YAG; Manufacturer Part Number RC0805FR-0727RL
R3, R4, R8, R9, R13, R14, R18, R19, R23, R24, R28, R29, R33, R34, R38, R39, R43, R44, R48, R49, R53, R54, R58, R59: 15; RES_R1632_ROM; Manufacturer Part Number LTR18EZPF15R0
R5, R10, R15, R20, R25, R30, R35, R40, R45, R50, R55, R60: 475; RESC2012X50N; Mouser Part Number 71-CRCW0805-475-E3
Z1, Z2, Z3, Z4, Z5, Z6, Z7, Z8, Z9, Z10, Z11, Z12: BZT52C5V6T-7; BZT52C5V6T7; Manufacturer Part Number BZT52C5V6T-7; Mouser Part Number 621-BZT52C5V6T-7

Connections:
C0: C1.2, C2.2, R1.2, R2.1
C1: C2.1, C3.1, R6.2, R7.1
C2: C3.2, C4.1, R11.2, R12.1
C3: C4.2, C5.1, R16.2, R17.1
C4: C5.2, C6.1, R21.2, R22.1
C5: C6.2, C7.1, R26.2, R27.1
C6: C7.2, C8.1, R31.2, R32.1
C7: C8.2, C9.1, R36.2, R37.1
C8: C9.2, C10.1, R41.2, R42.1
C9: C10.2, C11.1, R46.2, R47.1
C10: C11.2, C12.1, R51.2, R52.1
C11: C12.2, C13.1, R56.2, R57.1
C12: C13.2, R61.2
GND: C1.1, J1.1, Q1.2 (E), R1.1, Z1.2 (A)
unnamed: J1.2, Q2.2 (E), R3.2, R4.2, R5.2, R6.1, Z2.2 (A)
unnamed: J1.3, Q3.2 (E), R8.2, R9.2, R10.2, R11.1, Z3.2 (A)
unnamed: J1.4, Q4.2 (E), R13.2, R14.2, R15.2, R16.1, Z4.2 (A)
unnamed: J1.5, Q5.2 (E), R18.2, R19.2, R20.2, R21.1, Z5.2 (A)
unnamed: J1.6, Q6.2 (E), R23.2, R24.2, R25.2, R26.1, Z6.2 (A)
unnamed: J1.7, Q7.2 (E), R28.2, R29.2, R30.2, R31.1, Z7.2 (A)
unnamed: J1.8, Q8.2 (E), R33.2, R34.2, R35.2, R36.1, Z8.2 (A)
unnamed: J1.9, Q9.2 (E), R38.2, R39.2, R40.2, R41.1, Z9.2 (A)
unnamed: J1.10, Q10.2 (E), R43.2, R44.2, R45.2, R46.1, Z10.2 (A)
unnamed: J1.11, Q11.2 (E), R48.2, R49.2, R50.2, R51.1, Z11.2 (A)
unnamed: J1.12, Q12.2 (E), R53.2, R54.2, R55.2, R56.1, Z12.2 (A)
unnamed: J1.13, R58.2, R59.2, R60.2, R61.1
unnamed: LED1.1 (K), Q1.3 (C), R3.1, R4.1
unnamed: LED1.2 (A), R5.1
unnamed: LED2.1 (K), Q2.3 (C), R8.1, R9.1
unnamed: LED2.2 (A), R10.1
unnamed: LED3.1 (K), Q3.3 (C), R13.1, R14.1
unnamed: LED3.2 (A), R15.1
unnamed: LED4.1 (K), Q4.3 (C), R18.1, R19.1
unnamed: LED4.2 (A), R20.1
unnamed: LED5.1 (K), Q5.3 (C), R23.1, R24.1
unnamed: LED5.2 (A), R25.1
unnamed: LED6.1 (K), Q6.3 (C), R28.1, R29.1
unnamed: LED6.2 (A), R30.1
unnamed: LED7.1 (K), Q7.3 (C), R33.1, R34.1
unnamed: LED7.2 (A), R35.1
unnamed: LED8.1 (K), Q8.3 (C), R38.1, R39.1
unnamed: LED8.2 (A), R40.1
unnamed: LED9.1 (K), Q9.3 (C), R43.1, R44.1
unnamed: LED9.2 (A), R45.1
unnamed: LED10.1 (K), Q10.3 (C), R48.1, R49.1
unnamed: LED10.2 (A), R50.1
unnamed: LED11.1 (K), Q11.3 (C), R53.1, R54.1
unnamed: LED11.2 (A), R55.1
unnamed: LED12.1 (K), Q12.3 (C), R58.1, R59.1
unnamed: LED12.2 (A), R60.1
unnamed: Q1.1 (B), R2.2, Z1.1 (K)
unnamed: Q2.1 (B), R7.2, Z2.1 (K)
unnamed: Q3.1 (B), R12.2, Z3.1 (K)
unnamed: Q4.1 (B), R17.2, Z4.1 (K)
unnamed: Q5.1 (B), R22.2, Z5.1 (K)
unnamed: Q6.1 (B), R27.2, Z6.1 (K)
unnamed: Q7.1 (B), R32.2, Z7.1 (K)
unnamed: Q8.1 (B), R37.2, Z8.1 (K)
unnamed: Q9.1 (B), R42.2, Z9.1 (K)
unnamed: Q10.1 (B), R47.2, Z10.1 (K)
unnamed: Q11.1 (B), R52.2, Z11.1 (K)
unnamed: Q12.1 (B), R57.2, Z12.1 (K)

Notes on the sheet:
NOTE: Design based on section 2.4 (External Cell-Balancing Circuit Design Using BJTs) of the Cell Balancing With BQ769x2 Battery Monitors guide by TI, available at http://www.ti.com/lit/pdf/sluaa81
