AerospaceNU/bms-pcb-design/bms-kicad-project/FilterBalanceCell.kicad_sch

## KiCad design bms-kicad-project/FilterBalanceCell.kicad_sch (2025-08-27)

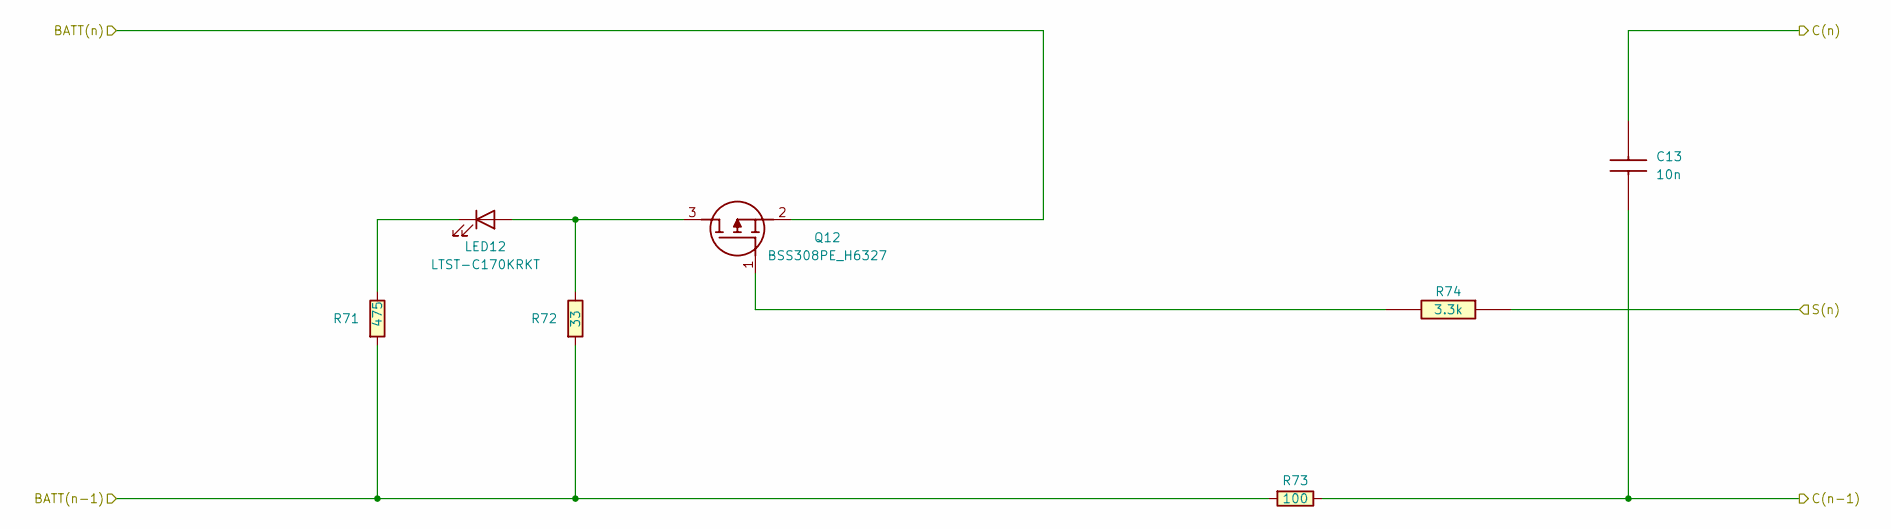
[picture p18: schematic FilterBalanceCell.kicad_sch]

Parts:
C13: 10n; CAPC2012X95N; Mouser Part Number 603-AC805KRX7R8BB103
LED12: LTST-C170KRKT; LEDC2012X120N; Mouser Part Number 859-LTST-C170KRKT
Q12: BSS308PE_H6327; SOT95P260X110-3N; Mouser Part Number 726-BSS308PEH6327
R71: 475; RESC2012X50N; Mouser Part Number 71-CRCW0805-475-E3
R72: 33; RC2512N_VIS; Manufacturer_Part_Number CRCW251233R0FKEG
R73: 100; RESC2012X50N; Mouser Part Number 71-CRCW0805-100-E3
R74: 3.3k; RESC2012X50N; Mouser Part Number 71-CRCW08053K30JNEA

Connections:
BATT(n): Q12.2 (S)
BATT(n-1): R71.1, R72.1, R73.1
C(n): C13.1
C(n-1): C13.2, R73.2
unnamed: LED12.1 (K), R71.2
unnamed: LED12.2 (A), Q12.3 (D), R72.2
unnamed: Q12.1 (G), R74.2
S(n): R74.1
