AerospaceNU/bms-pcb-design/bms-kicad-project/Microcontroller.kicad_sch

## KiCad design bms-kicad-project/Microcontroller.kicad_sch (2026-05-07)

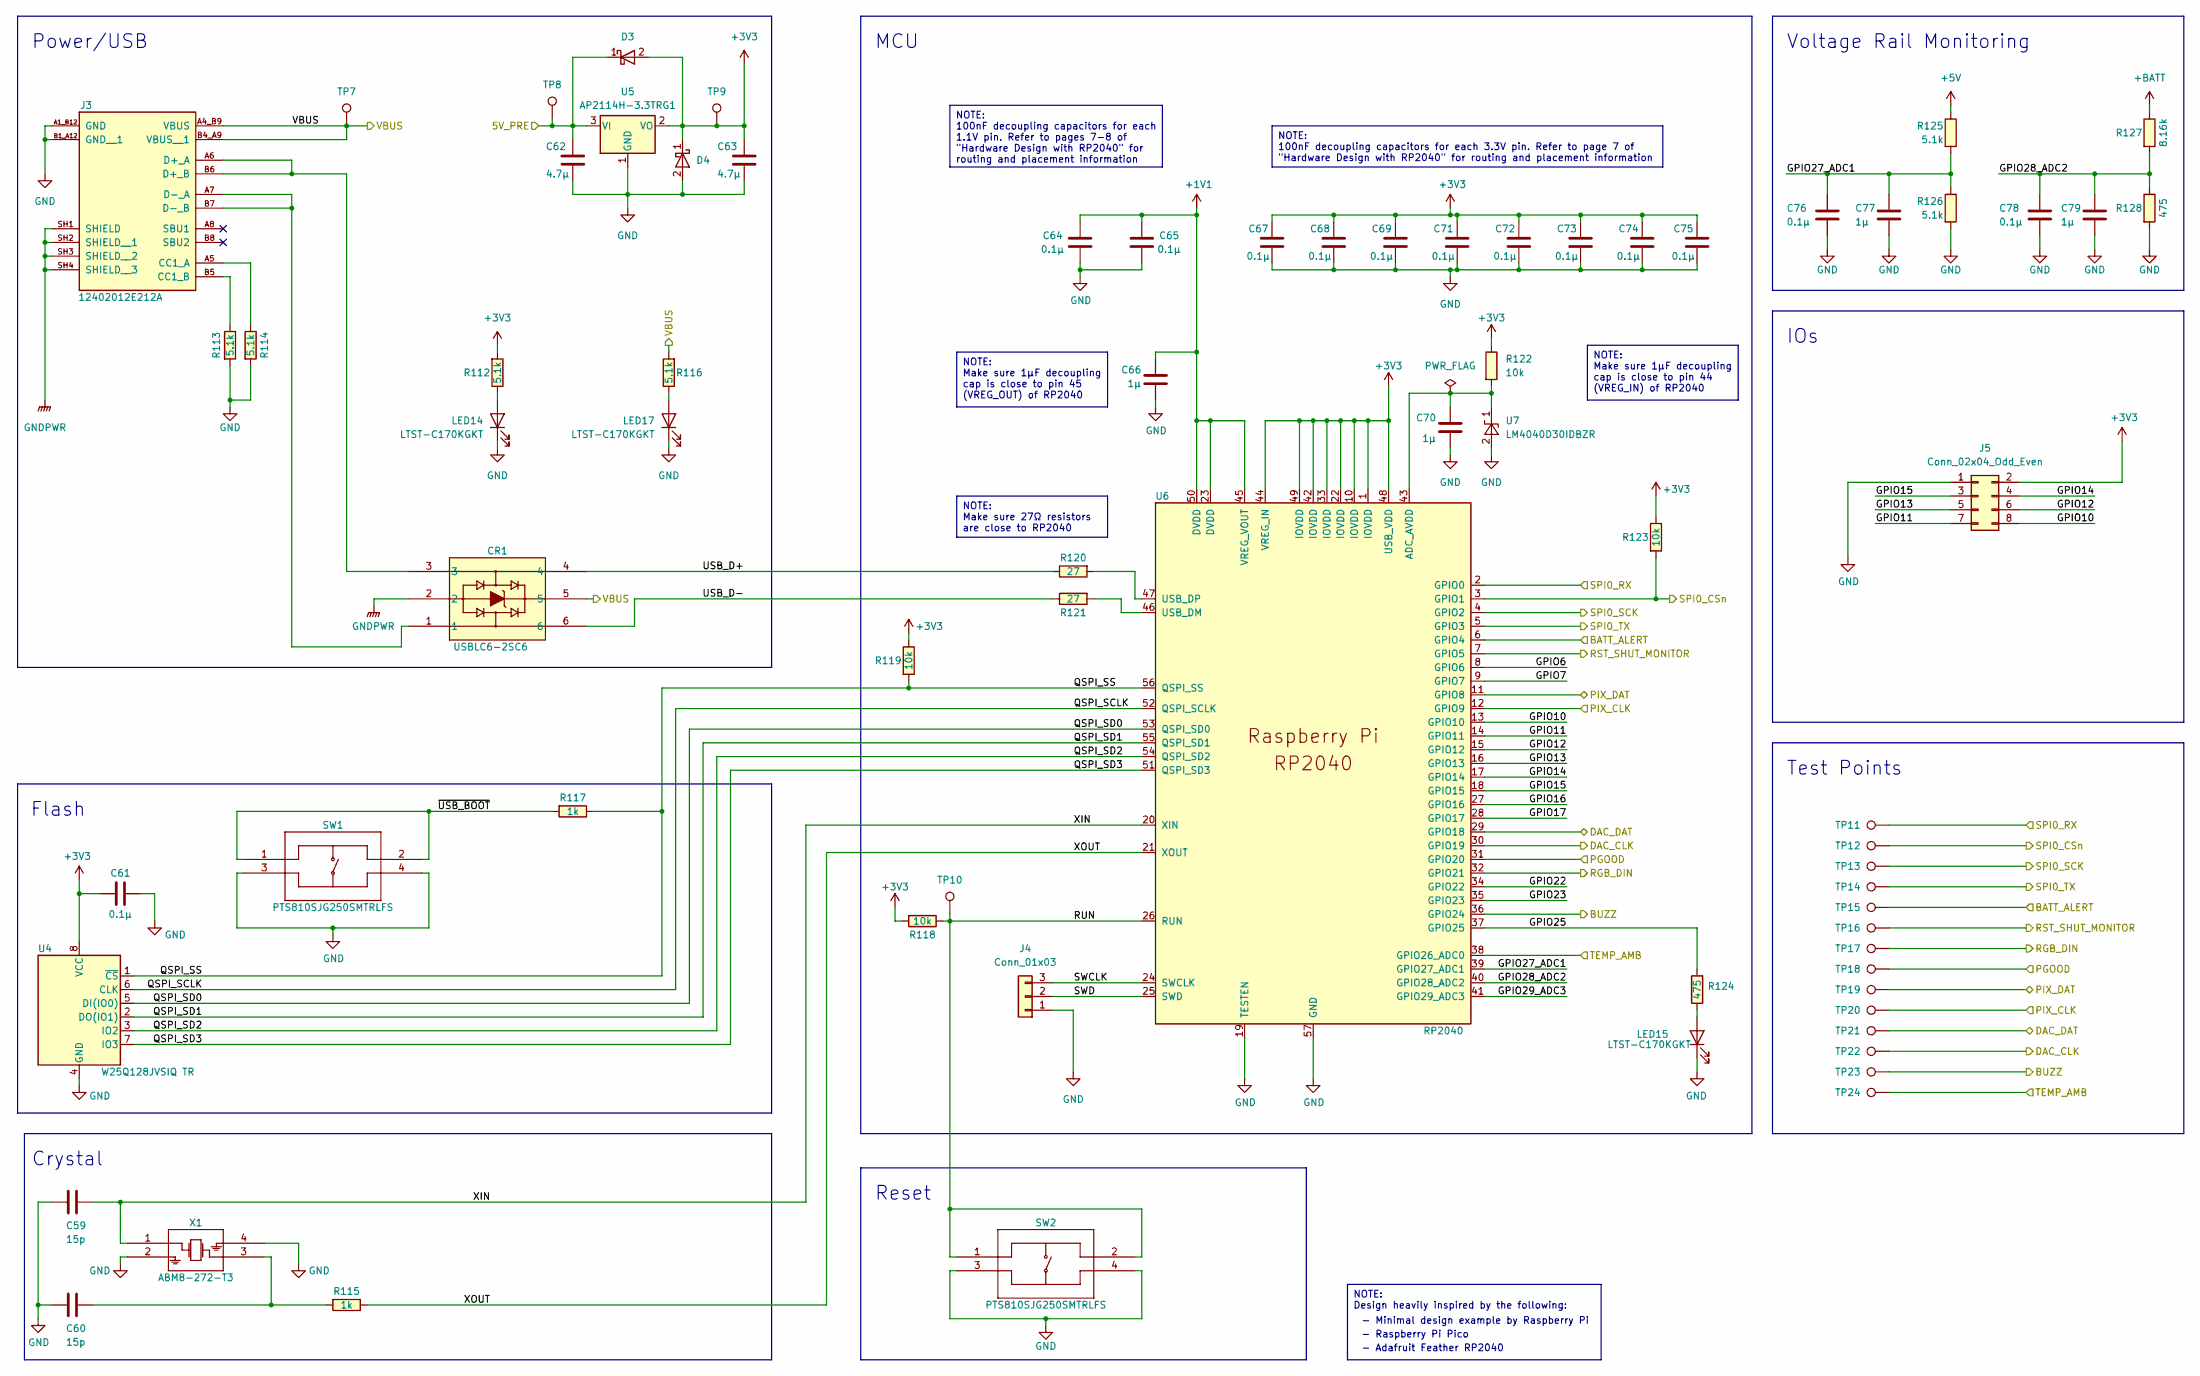
[picture p19: schematic Microcontroller.kicad_sch]

Parts:
C59, C60: 15p; CAPC2012X70; Manufacturer_Part_Number CC0805JPNPO9BN150
C61, C64, C65, C67, C68, C69, C71, C72, C73, C74, C75: 0.1µ; CAP_GCJ-18_MUR; Manufacturer_Part_Number GCJ188R72A104KA01D
C62, C63: 4.7µ; CAPC2012X145N; Manufacturer Part Number GCM21BC71E475KE36L
C66, C70, C77, C79: 1µ; CAPC1608X90N; Manufacturer Part Number GCM188R71C105KA64D
C76, C78: 0.1µ; CAP_GCJ-18_MUR; Manufacturer Part Number GCJ188R72A104KA01D
CR1: USBLC6-2SC6; SOT23-6L_STM; Manufacturer Part Number USBLC6-2SC6
D3, D4: 100V; D_SOD-123; Manufacturer Part Number BAS100AS_R1_00001
J3: 12402012E212A; AMPHENOL_12402012E212A; PARTREV 4
J4: Conn_01x03; PinHeader_1x03_P2.54mm_Vertical
J5: Conn_02x04_Odd_Even; PinHeader_2x04_P2.54mm_Vertical
LED14, LED15, LED17: LTST-C170KGKT; LED_LTST-C170KGKT_LTO; Manufacturer Part Number LTST-C170KGKT
R112, R113, R114, R116, R125, R126: 5.1k; RESC2012X60N; Manufacturer Part Number RC0805JR-075K1L
R115, R117: 1k; RC0805N_YAG; Manufacturer_Part_Number RC0805FR-071KL
R118, R119, R122, R123: 10k; KOA_Speer-RK73H2A-0-0-MFG; power rating 0.125W; tolerance 1%; Manufacturer Part Number RK73H2ATTD1002F; digikey description RES 10K OHM 1% 1/4W 0805
R120, R121: 27; RC0805N_YAG; Manufacturer_Part_Number RC0805FR-0727RL
R124, R128: 475; RESC2012X50N; Mouser Part Number 71-CRCW0805-475-E3
R127: 8.16k; RC0805N_YAG; Manufacturer Part Number RT0805BRD078K16L
SW1, SW2: PTS810SJG250SMTRLFS; PTS810; Manufacturer Part Number PTS810SJG250SMTR LFS
TP7, TP8, TP9, TP10, TP11, TP12, TP13, TP14, TP15, TP16, TP17, TP18, TP19, TP20, TP21, TP22, TP23, TP24: TestPoint_Pad_D1.0mm
U4: W25Q128JVSIQ TR; SOIC_208MIL_WIN; Manufacturer_Part_Number W25Q128JVSIQ TR
U5: AP2114H-3.3TRG1; SOT223-3_ONS; Manufacturer Part Number AP2114H-3.3TRG1
U6: RP2040; RP2040-QFN-56; Manufacturer_Part_Number SC0914(13)
U7: LM4040D30IDBZR; DBZ3_TEX; Manufacturer Part Number LM4040D30IDBZR
X1: ABM8-272-T3; ABM8-272-T3_ABR; Manufacturer_Part_Number ABM8-272-T3

Connections:
5V_PRE: C62.1, D3.1, TP8.1, U5.3 (VI)
+1V1: C64.2, C65.2, C66.2, U6.23 (DVDD), U6.45 (VREG_VOUT), U6.50 (DVDD)
+3V3: C61.1, C63.2, C67.1, C68.1, C69.2, C71.1, C72.1, C73.1, C74.1, C75.1, D3.2, D4.1, J5.2, R112.1, R118.1, R119.2, R122.2, R123.2, TP9.1, U4.8 (VCC), U5.2 (VO), U6.1 (IOVDD), U6.10 (IOVDD), U6.22 (IOVDD), U6.33 (IOVDD), U6.42 (IOVDD), U6.44 (VREG_IN), U6.48 (USB_VDD), U6.49 (IOVDD)
+5V: R125.2
+BATT: R127.1
BATT_ALERT: TP15.1, U6.6 (GPIO4)
BUZZ: TP23.1, U6.36 (GPIO24)
DAC_CLK: TP22.1, U6.30 (GPIO19)
DAC_DAT: TP21.1, U6.29 (GPIO18)
GND: C59.1, C60.1, C61.2, C62.2, C63.1, C64.1, C65.1, C66.1, C67.2, C68.2, C69.1, C70.1, C71.2, C72.2, C73.2, C74.2, C75.2, C76.1, C77.1, C78.1, C79.1, D4.2, J3.A1_B12 (GND), J3.B1_A12 (GND__1), J4.1, J5.1, LED14.1 (K), LED15.1 (K), LED17.1 (K), R113.1, R114.1, R126.1, R128.1, SW1.3, SW1.4, SW2.3, SW2.4, U4.4 (GND), U5.1 (GND), U6.19 (TESTEN), U6.57 (GND), U7.2 (A), X1.2, X1.4
GNDPWR: CR1.2, J3.SH1 (SHIELD), J3.SH2 (SHIELD__1), J3.SH3 (SHIELD__2), J3.SH4 (SHIELD__3)
GPIO6: U6.8 (GPIO6)
GPIO7: U6.9 (GPIO7)
GPIO10: J5.8, U6.13 (GPIO10)
GPIO11: J5.7, U6.14 (GPIO11)
GPIO12: J5.6, U6.15 (GPIO12)
GPIO13: J5.5, U6.16 (GPIO13)
GPIO14: J5.4, U6.17 (GPIO14)
GPIO15: J5.3, U6.18 (GPIO15)
GPIO16: U6.27 (GPIO16)
GPIO17: U6.28 (GPIO17)
GPIO22: U6.34 (GPIO22)
GPIO23: U6.35 (GPIO23)
GPIO25: R124.1, U6.37 (GPIO25)
GPIO27_ADC1: C76.2, C77.2, R125.1, R126.2, U6.39 (GPIO27_ADC1)
GPIO28_ADC2: C78.2, C79.2, R127.2, R128.2, U6.40 (GPIO28_ADC2)
GPIO29_ADC3: U6.41 (GPIO29_ADC3)
unnamed: C60.2, R115.1, X1.3
unnamed: C70.2, R122.1, U6.43 (ADC_AVDD), U7.1 (K)
unnamed: CR1.1, J3.A7 (D-_A), J3.B7 (D-_B)
unnamed: CR1.3, J3.A6 (D+_A), J3.B6 (D+_B)
unnamed: J3.A5 (CC1_A), R114.2
unnamed: J3.B5 (CC1_B), R113.2
unnamed: LED14.2 (A), R112.2
unnamed: LED15.2 (A), R124.2
unnamed: LED17.2 (A), R116.2
unnamed: R120.1, U6.47 (USB_DP)
unnamed: R121.1, U6.46 (USB_DM)
PGOOD: TP18.1, U6.31 (GPIO20)
PIX_CLK: TP20.1, U6.12 (GPIO9)
PIX_DAT: TP19.1, U6.11 (GPIO8)
QSPI_SCLK: U4.6 (CLK), U6.52 (QSPI_SCLK)
QSPI_SD0: U4.5 (DI(IO0)), U6.53 (QSPI_SD0)
QSPI_SD1: U4.2 (DO(IO1)), U6.55 (QSPI_SD1)
QSPI_SD2: U4.3 (IO2), U6.54 (QSPI_SD2)
QSPI_SD3: U4.7 (IO3), U6.51 (QSPI_SD3)
QSPI_SS: R117.2, R119.1, U4.1 (~CS), U6.56 (QSPI_SS)
RGB_DIN: TP17.1, U6.32 (GPIO21)
RST_SHUT_MONITOR: TP16.1, U6.7 (GPIO5)
RUN: R118.2, SW2.1, SW2.2, TP10.1, U6.26 (RUN)
SPI0_CSn: R123.1, TP12.1, U6.3 (GPIO1)
SPI0_RX: TP11.1, U6.2 (GPIO0)
SPI0_SCK: TP13.1, U6.4 (GPIO2)
SPI0_TX: TP14.1, U6.5 (GPIO3)
SWCLK: J4.3, U6.24 (SWCLK)
SWD: J4.2, U6.25 (SWD)
TEMP_AMB: TP24.1, U6.38 (GPIO26_ADC0)
USB_D+: CR1.4, R120.2
USB_D-: CR1.6, R121.2
VBUS: CR1.5, J3.A4_B9 (VBUS), J3.B4_A9 (VBUS__1), R116.1, TP7.1
XIN: C59.2, U6.20 (XIN), X1.1
XOUT: R115.2, U6.21 (XOUT)
~USB_BOOT: R117.1, SW1.1, SW1.2

Notes on the sheet:
NOTE: Design heavily inspired by the following:
NOTE: Make sure 1μF decoupling cap is close to pin 45 (VREG_OUT) of RP2040
NOTE: 100nF decoupling capacitors for each 3.3V pin. Refer to page 7 of "Hardware Design with RP2040" for routing and placement information
NOTE: Make sure 1μF decoupling cap is close to pin 44 (VREG_IN) of RP2040
NOTE: 100nF decoupling capacitors for each 1.1V pin. Refer to pages 7-8 of "Hardware Design with RP2040" for routing and placement information
NOTE: Make sure 27Ω resistors are close to RP2040
IOs
Power/USB
Crystal
- Raspberry Pi Pico
- Adafruit Feather RP2040
- Minimal design example by Raspberry Pi
Voltage Rail Monitoring
MCU
Test Points
Reset
Flash
