AerospaceNU/bms-pcb-design/bms-kicad-project/SensingConnections.kicad_sch

## KiCad design bms-kicad-project/SensingConnections.kicad_sch (2026-05-07)

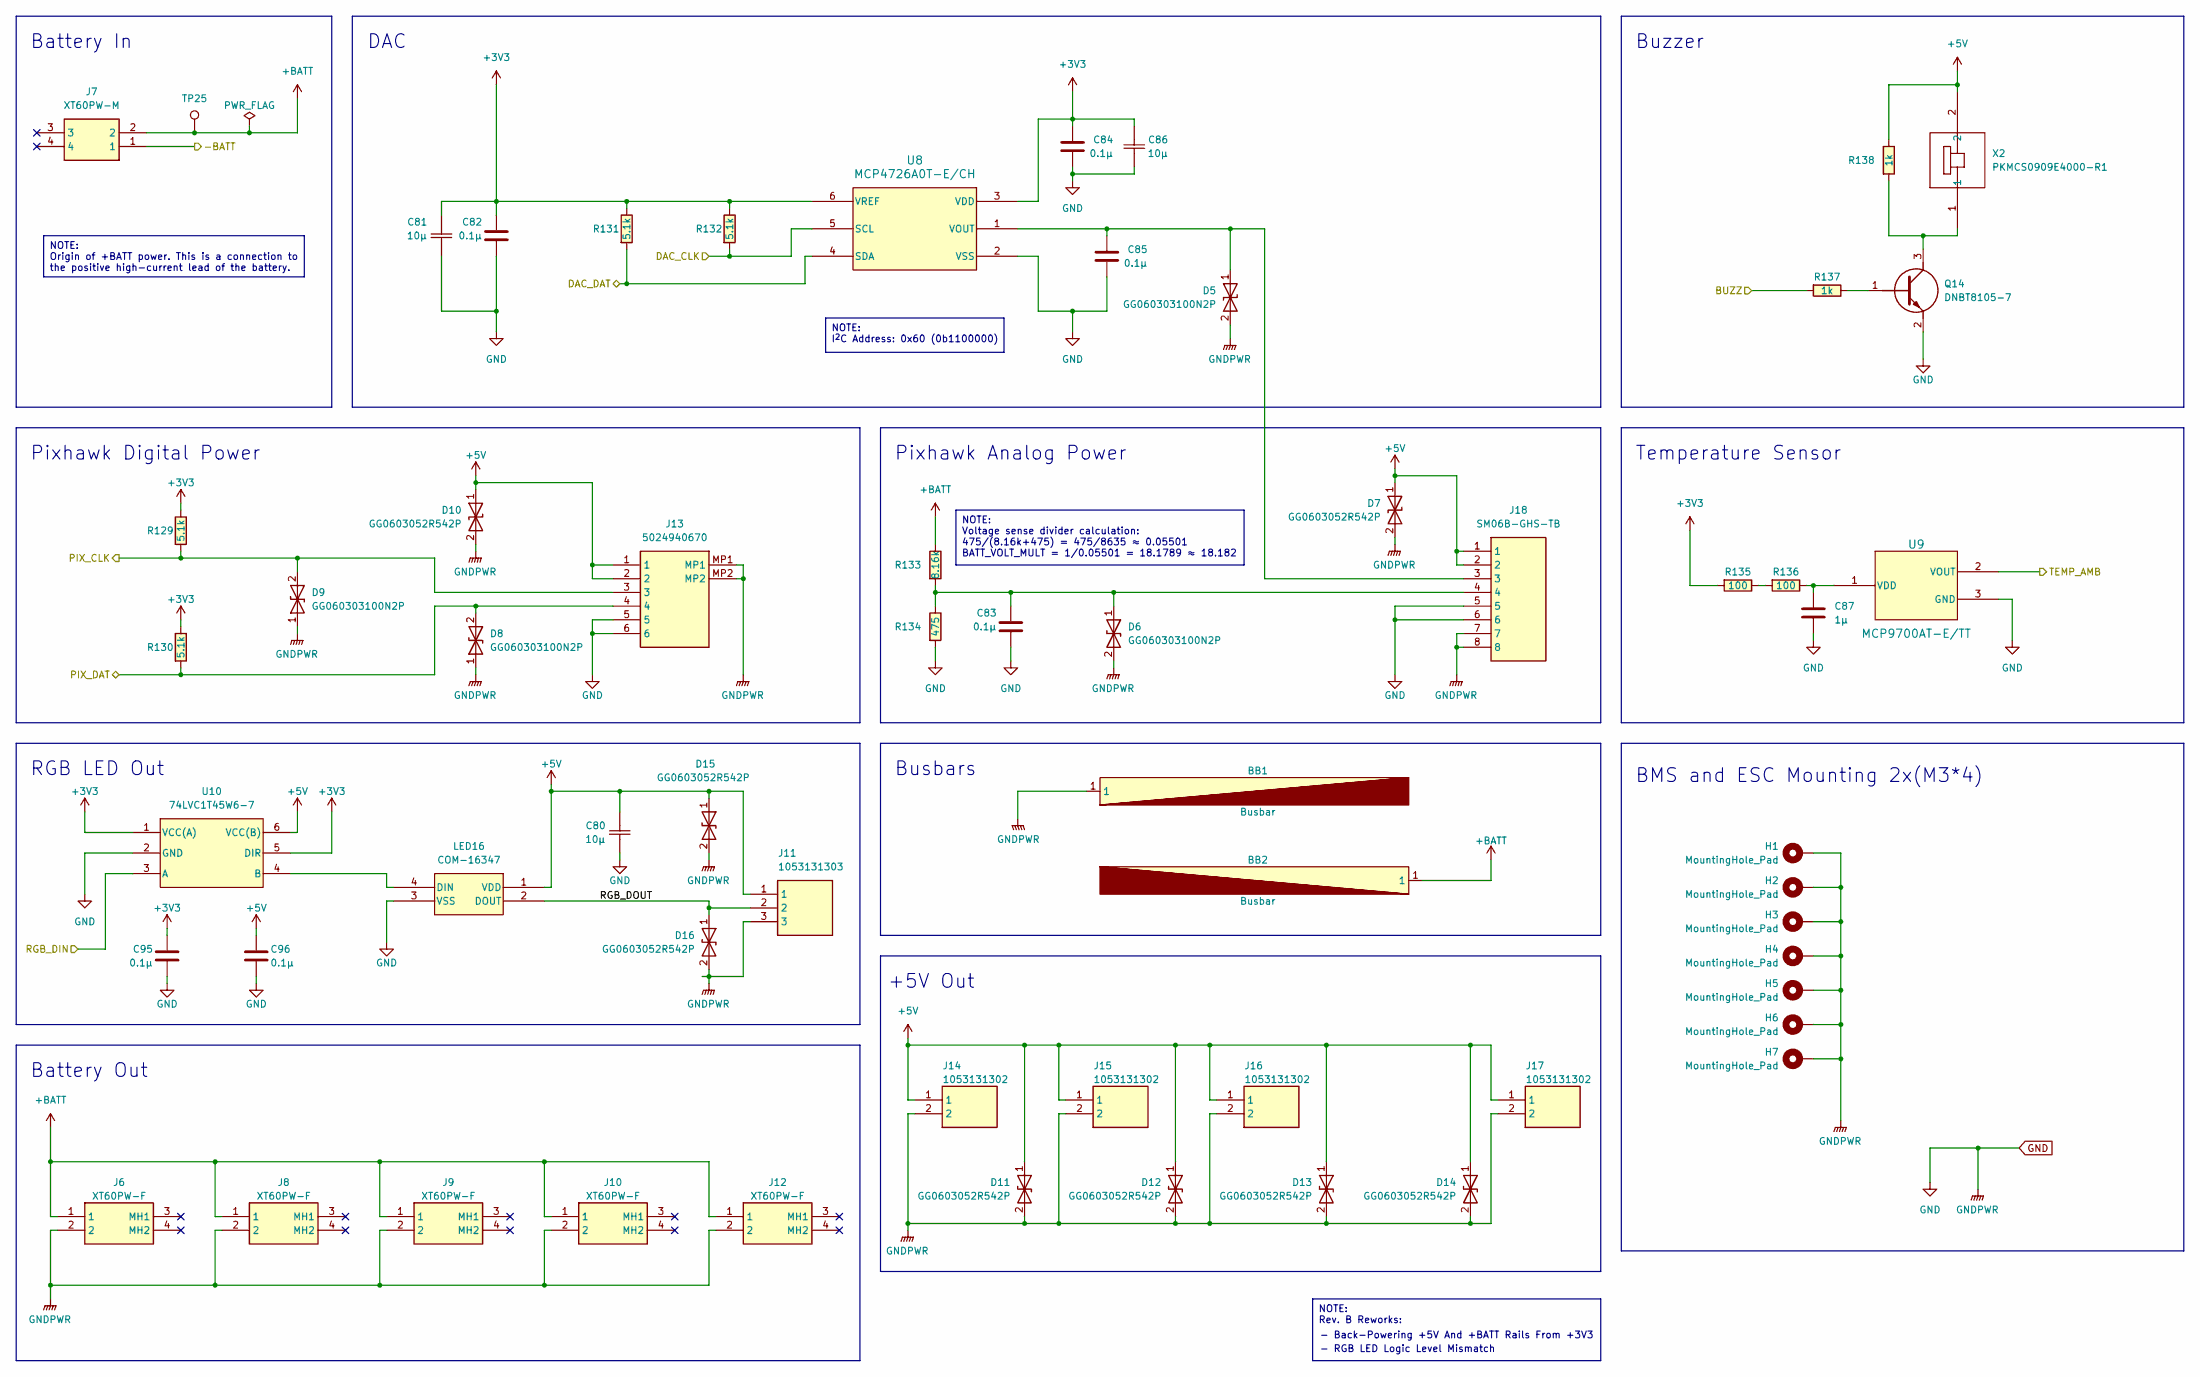
[picture p20: schematic SensingConnections.kicad_sch]

Parts:
BB1: Busbar; BUSBAR_SHORT; Manufacturer Part Number T2 Copper
BB2: Busbar; BUSBAR_LONG; Manufacturer Part Number T2 Copper
C80, C81, C86: 10µ; CAP_CL21B106KOQNNNE_SAM; Manufacturer Part Number CL21B106KOQNNNE
C82, C83, C84, C85, C95, C96: 0.1µ; CAP_GCJ-18_MUR; Manufacturer Part Number GCJ188R72A104KA01D
C87: 1µ; CAPC1608X90N; Manufacturer Part Number GCM188R71C105KA64D
D5, D6, D8, D9: GG060303100N2P; DIONC1608X70N; Manufacturer Part Number GG060303100N2P
D7, D10, D11, D12, D13, D14, D15, D16: GG0603052R542P; DIONC1608X70N; Manufacturer Part Number GG0603052R542P
H1, H2, H3, H4, H5, H6, H7: MountingHole_Pad; MountingHole_3.2mm_M3_ISO14580_Pad
J6, J8, J9, J10: XT60PW-F; XT60PWF; Manufacturer Part Number XT60PW-F
J7: XT60PW-M; XT60PWM_Pad; Manufacturer Part Number XT60PW-M
J11: 1053131303; 105313YY03; Manufacturer Part Number 1053131303
J12: XT60PW-F; XT60PWF_Pad; Manufacturer Part Number XT60PW-F
J13: 5024940670; Manufacturer Part Number 5024940670; Mouser Part Number 538-502494-0670
J14, J15, J16, J17: 1053131302; 105313YY02; Manufacturer Part Number 1053131302
J18: SM06B-GHS-TB; Manufacturer Part Number SM06B-GHS-TB(LF)(SN); Mouser Part Number 306-SM06BGHSTBLFSN
LED16: COM-16347; COM-16347_SPK; Manufacturer Part Number COM-16347
Q14: DNBT8105-7; SOT95P240X105-3N; Manufacturer Part Number DNBT8105-7; Mouser Part Number 621-DNBT8105-7
R129, R130, R131, R132: 5.1k; RESC2012X60N; Manufacturer Part Number RC0805JR-075K1L
R133: 8.16k; RC0805N_YAG; Manufacturer Part Number RT0805BRD078K16L
R134: 475; RESC2012X50N; Mouser Part Number 71-CRCW0805-475-E3
R135, R136: 100; RESC2012X50N; Mouser Part Number 71-CRCW0805-100-E3
R137, R138: 1k; RC0805N_YAG; Manufacturer Part Number RC0805FR-071KL
TP25: TestPoint_Pad_D1.0mm
U8: MCP4726A0T-E/CH; SOT-23-6_MC_MCH; Manufacturer Part Number MCP4726A0T-E/CH
U9: MCP9700AT-E/TT; SOT-23_MC_MCH; Manufacturer Part Number MCP9700AT-E/TT
U10: 74LVC1T45W6-7; SOT26-6_DIO; Manufacturer Part Number 74LVC1T45W6-7
X2: PKMCS0909E4000-R1; PKMCS0909E4000-R1_MUR; Manufacturer Part Number PKMCS0909E4000-R1

Connections:
+3V3: C81.2, C82.2, C84.2, C86.2, C95.1, R129.2, R130.2, R131.2, R132.2, R135.1, U8.3 (VDD), U8.6 (VREF), U10.1 (VCC(A)), U10.5 (DIR)
+5V: C80.2, C96.1, D7.1 (A1), D10.1 (A1), D11.1 (A1), D12.1 (A1), D13.1 (A1), D14.1 (A1), D15.1 (A1), J11.1, J13.1, J13.2, J14.1, J15.1, J16.1, J17.1, J18.1, J18.2, LED16.1 (VDD), R138.2, U10.6 (VCC(B)), X2.2
+BATT: BB2.1, J6.1, J7.2, J8.1, J9.1, J10.1, J12.1, R133.1, TP25.1
-BATT: J7.1
BUZZ: R137.1
DAC_CLK: R132.1, U8.5 (SCL)
DAC_DAT: R131.1, U8.4 (SDA)
GND: BB1.1, C80.1, C81.1, C82.1, C83.1, C84.1, C85.1, C86.1, C87.1, C95.2, C96.2, D5.2 (A2), D6.2 (A2), D7.2 (A2), D8.1 (A1), D9.1 (A1), D10.2 (A2), D11.2 (A2), D12.2 (A2), D13.2 (A2), D14.2 (A2), D15.2 (A2), D16.2 (A2), H1.1, H2.1, H3.1, H4.1, H5.1, H6.1, H7.1, J6.2, J8.2, J9.2, J10.2, J11.3, J12.2, J13.5, J13.6, J13.MP1, J13.MP2, J14.2, J15.2, J16.2, J17.2, J18.5, J18.6, J18.7, J18.8, LED16.3 (VSS), Q14.2 (E), R134.1, U8.2 (VSS), U9.3 (GND), U10.2 (GND)
unnamed: C83.2, D6.1 (A1), J18.4, R133.2, R134.2
unnamed: C85.2, D5.1 (A1), J18.3, U8.1 (VOUT)
unnamed: C87.2, R136.2, U9.1 (VDD)
unnamed: LED16.4 (DIN), U10.4 (B)
unnamed: Q14.1 (B), R137.2
unnamed: Q14.3 (C), R138.1, X2.1
unnamed: R135.2, R136.1
PIX_CLK: D9.2 (A2), J13.3, R129.1
PIX_DAT: D8.2 (A2), J13.4, R130.1
RGB_DIN: U10.3 (A)
RGB_DOUT: D16.1 (A1), J11.2, LED16.2 (DOUT)
TEMP_AMB: U9.2 (VOUT)

Notes on the sheet:
NOTE: Voltage sense divider calculation: 475/(8.16k+475) = 475/8635 ≈ 0.05501 BATT_VOLT_MULT = 1/0.05501 = 18.1789 ≈ 18.182
NOTE: I^{2}C Address: 0x60 (0b1100000)
NOTE: Origin of +BATT power. This is a connection to the positive high-current lead of the battery.
NOTE: Rev. B Reworks:
Battery In
Buzzer
- Back-Powering +5V And +BATT Rails From +3V3
RGB LED Out
Battery Out
DAC
Pixhawk Analog Power
BMS and ESC Mounting 2x(M3*4)
Pixhawk Digital Power
Temperature Sensor
+5V Out
- RGB LED Logic Level Mismatch
Busbars
