AerospaceNU/bms-pcb-design/breakout-boards/BJT_CELL_BALANCING/bjt_cell_balancing/bjt_cell_balancing.kicad_sch

## KiCad design breakout-boards/BJT_CELL_BALANCING/bjt_cell_balancing/bjt_cell_balancing.kicad_sch (2025-08-27)

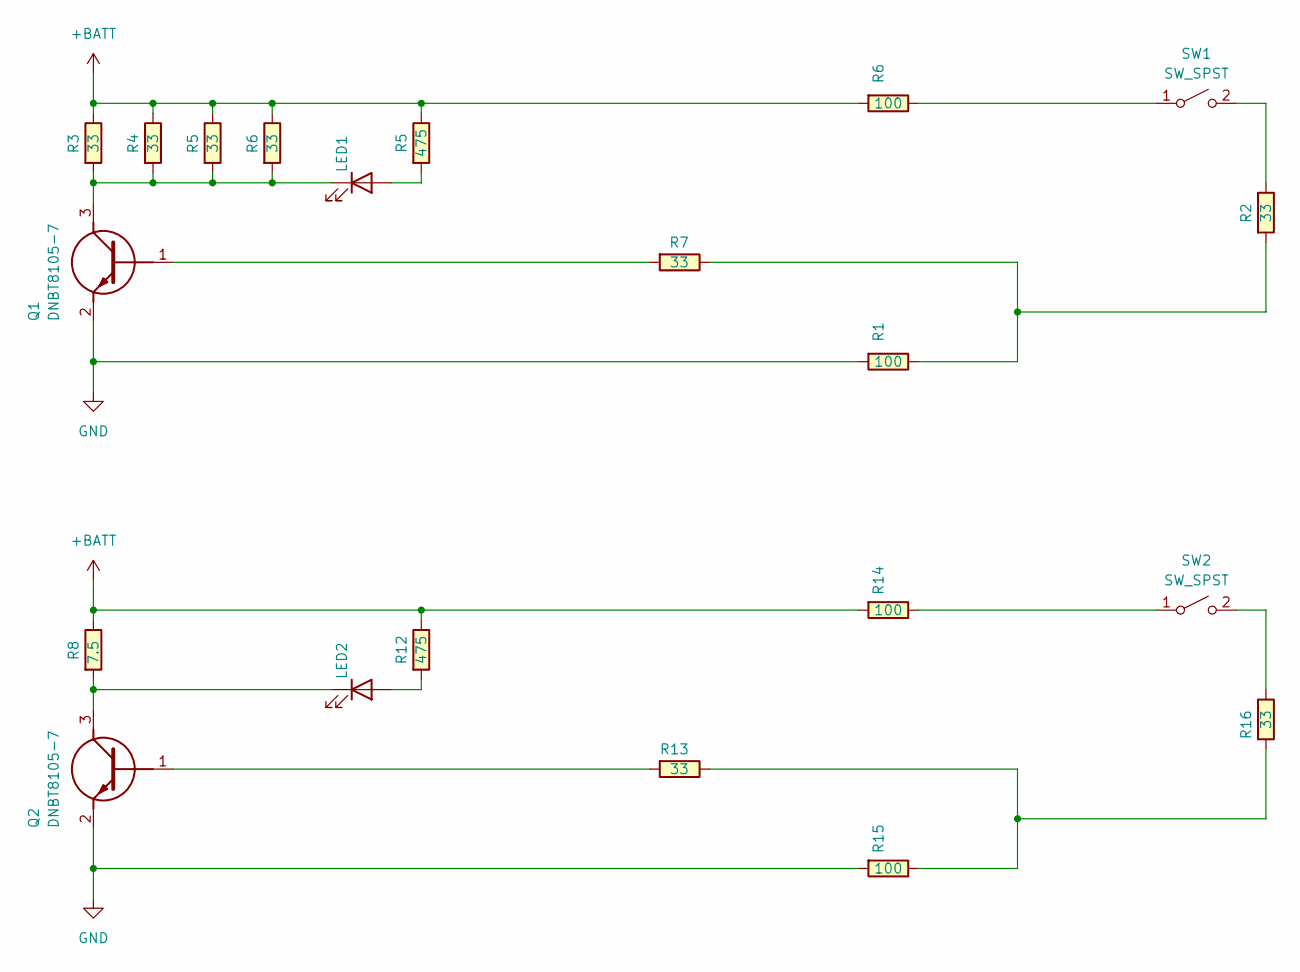
[picture p21: schematic bjt_cell_balancing.kicad_sch]

Parts:
LED1, LED2: LTST-C170KRKT; LEDC2012X120N; Mouser Part Number 859-LTST-C170KRKT
Q1, Q2: DNBT8105-7; SOT95P240X105-3N; Manufacturer Part Number DNBT8105-7; Mouser Part Number 621-DNBT8105-7
R1, R6, R14, R15: 100; RESC2012X50N; Mouser Part Number 71-CRCW0805-100-E3
R2, R3, R4, R5, R7, R13, R16: 33; RC2512N_VIS; Manufacturer Part Number CRCW251233R0FKEG
R8: 7.5; RC2512N_VIS; Manufacturer Part Number CRCW251233R0FKEG
R12: 475; RESC2012X50N; Mouser Part Number 71-CRCW0805-475-E3
SW1, SW2: SW_SPST

Connections:
+BATT: R3.2, R4.2, R5.2, R6.1, R6.2, R8.2, R12.2, R14.1
GND: Q1.2 (E), Q2.2 (E), R1.1, R15.1
unnamed: LED1.1 (K), Q1.3 (C), R3.1, R4.1, R5.1, R6.1
unnamed: LED1.2 (A), R5.1
unnamed: LED2.1 (K), Q2.3 (C), R8.1
unnamed: LED2.2 (A), R12.1
unnamed: Q1.1 (B), R7.1
unnamed: Q2.1 (B), R13.1
unnamed: R1.2, R2.1, R7.2
unnamed: R2.2, SW1.2 (B)
unnamed: R6.2, SW1.1 (A)
unnamed: R13.2, R15.2, R16.1
unnamed: R14.2, SW2.1 (A)
unnamed: R16.2, SW2.2 (B)
