AerospaceNU/bms-pcb-design/(commit log)

2024-02-13 feat: initial commit
    [bms-board.kicad_pcb, bms-board.kicad_sch]
2024-02-15 feat: add 6804-2 kicad symbol
2024-02-15 feat: add 6804-2 kicad symbol (#3)
2024-02-16 feat: add automated git flow setup script
2024-02-16 update feature/add-cells branch to latest develop edition (#4)
    * feat: add 6804-2 kicad symbol
    * TEMPLATE: add pull request description template
    * feat: add automated git flow setup script
2024-02-16 update feature/our-symbol-library branch to latest develop edition (#5)
    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
2024-02-20 feat: a maybe working fixed wing schematic symbol library
2024-02-21 feat: adding needed files
    [bms-board.kicad_sch]
2024-02-21 Merging new develop into new feature (#6)
    * update feature/our-symbol-library branch to latest develop edition (#5)
    * feat: a maybe working fixed wing schematic symbol library
    * feat: add line to checkout dev branch when running setup script
    * feat: fix FixedWing symbol library to include LTC6804-2
    * refactor: verifying symbol library works, remove individual ltc6804-2 symbol
    * feat: adding needed files
    * feat: edit conflict in setup script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
    [bms-board.kicad_sch]
2024-02-22 fix: changed symbol for easier schematic design and orginization by pin logic
    [bms-board.kicad_sch]
2024-02-23 Release/0.1 (#8)
    * feat: add 6804-2 kicad symbol (#3)
    * update feature/add-cells branch to latest develop edition (#4)
    * feat: add line to checkout dev branch when running setup script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
    [bms-board.kicad_sch]
2025-08-27 Rev A Release (#20)
    * Feature: add cells, create breakout boards, restructure project files (#14)
    * feat: started adding cell nets
    * feat: still some more LTC6804-2 symbol edits
    * feat: add schematic hierarchy
    * feat: add JST-XH 7pin symbol
    * feat: add filtering components in library
    * feat: add more symbols, some traces, sheet template
    * feat: add filtering circuit
    * feat: resolved splitting cells across monitor
    * feat: add footprints
    * feat: update PCB schematic
    * feat: restructure project, move libraries to parent folder (#13)
    * refactor: move sheet template to libraries folder
    * fix: add relative path to AeroNU sheet template
    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
    [5VRegulator.kicad_sch, AC0805KRX7R8BB103.kicad_pcb, AC0805KRX7R8BB103.kicad_sch, AC0805KRX7R8BB103_panel.kicad_pcb, BSS308PEH6327.kicad_pcb, BSS308PEH6327.kicad_sch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]
2025-09-09 hot fix: fix AP2114H-3.3TRG1 name
    [Microcontroller.kicad_sch]
2026-04-23 hotfix: final rev. A cleanup
    [BatteryMonitor.kicad_sch, Microcontroller.kicad_sch, bms-board.csv, switch-ldo.kicad_pcb, switch-ldo.kicad_sch]
2026-05-06 feat: initial pass at rev. B
    [5VPower.kicad_sch, 5VRegulator.kicad_sch, BatteryMonitor.kicad_sch, Microcontroller.kicad_sch, PowerTree.kicad_sch, SensingConnections.kicad_sch, bms-board.kicad_sch]
2026-05-07 feat: finalizing BOM
    [5VPower.kicad_sch, BatteryMonitor.kicad_sch, CellFilteringAndBalancing.kicad_sch, Microcontroller.kicad_sch, PowerTree.kicad_sch, SensingConnections.kicad_sch, bms-board.csv, bms-board.kicad_sch]
2026-05-07 feat: Rev. B release
    [5VPower.kicad_sch, BatteryMonitor.kicad_sch, CellFilteringAndBalancing.kicad_sch, Microcontroller.kicad_sch, PowerTree.kicad_sch, SensingConnections.kicad_sch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]
